judapies/Cabina-Extractora/2015/Cabina Extractora Simple/Cabina Extractora 120 - MAT/Plano Electrico/IMG_4619.JPG

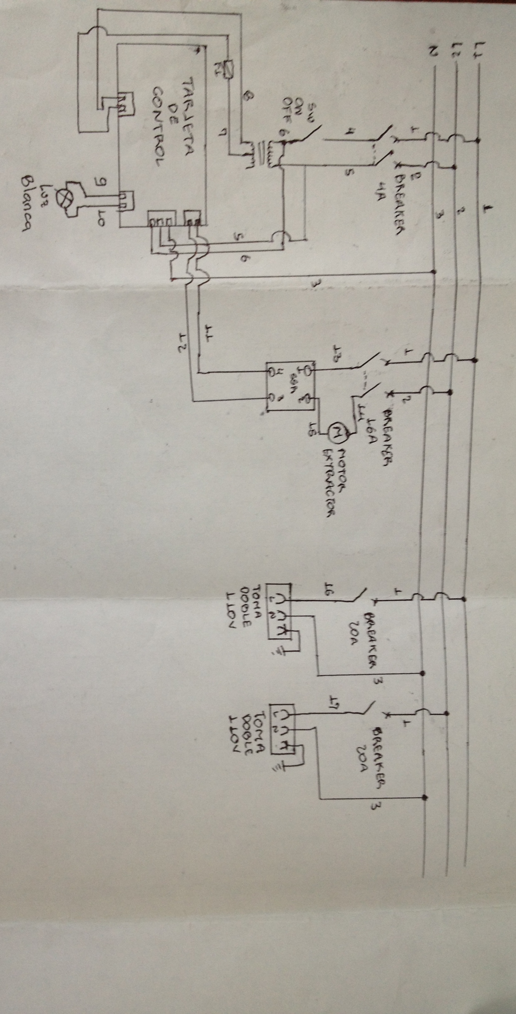
2015/Cabina Extractora Simple/Cabina Extractora 120 - MAT/Plano Electrico/IMG_4619.JPG
