judapies/Cabina-Extractora/2021/Cabina Extractora con Filtros HMI 120PP Avantika #0045886XX-XX OP2021140-141/Interfaz Nextion CEGH 3.5/Imagenes/SOFTWARE_AUTOCLAVE _HORIZONTAL_68L-01.png

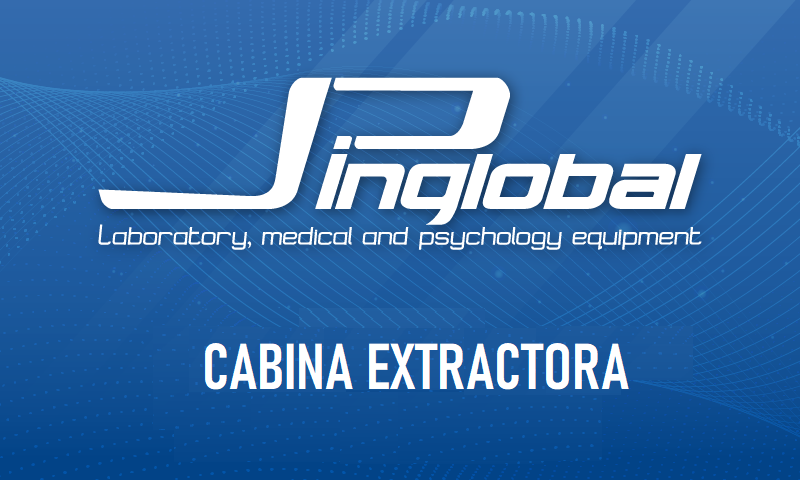
2021/Cabina Extractora con Filtros HMI 120PP Avantika #0045886XX-XX OP2021140-141/Interfaz Nextion CEGH 3.5/Imagenes/SOFTWARE_AUTOCLAVE _HORIZONTAL_68L-01.png
