judapies/Cabina-Extractora/2017/110/Cabina Extractora 110 Instruelectronic #004587680/Documentos/Motores_Amazonia.txt

Invermotor
Angie

Motor Trifasico 
1/2 HP Dixus 1200 RPM ->280000 IVA incluido con patas
1/2 HP WEG   1200 RPM ->401200 IVA incluido

Orbelec

Motor Trifasico 
Giovanny Diaz
1 HP WEG  1200 RPM ->468500 + IVA con patas

f y v

1/2 HP Siemens  1200 RPM ->354640 + IVA con patas

7452053
ext 111

Monica Bernal
PC Quimica
