judapies/Cabina-Extractora/2021/Cabina Extractora Sin Ductos 90TOPA GLCD CEMMIT #004588499 OP202114/Schematic/Gerber_Mufla/Mufla - CADCAM Mechanical 1.TXT

G04 PROTEUS RS274X GERBER FILE*
%FSLAX24Y24*%
%MOIN*%
%ADD22C,0.0080*%
G54D22*
X+0Y+0D02*
X+39133Y+0D01*
X+39133Y+30905D01*
X+0Y+30905D01*
X+0Y+0D01*
M00*
