judapies/Cabina-Extractora/2016/Cabina Sin Ductos Avantika #004587580/Plano Electrico CEH Sin Ductos/Pines Conectores Metalicos.txt

---------Luz Blanca--------------
#29->Pin 3
#28->Pin 1
---------------------------------
---------Luz UV------------------
#24->Pin 3
#22->Pin 1
---------------------------------
---------Motor ------------------
#19->Pin 3
#17->Pin 1
---------------------------------
---------Vidrio Abajo------------
#16->Pin 1
#20->Pin 2
#18->Pin 3
---------------------------------
---------Vidrio Arriba-----------
#21->Pin 1
#25->Pin 2
#23->Pin 3
---------------------------------
---------Sensor Flujo------------
Conector 5PINES
#10->Pin 1
#12->Pin 2
#13->Pin 3
#14->Pin 4
#15->Pin 5
---------------------------------
---------Motor Vidrio------------
#35->Pin 2
#34->Pin 1
---------------------------------

---------DAMPER------------------
Conector 5PINES
#27->Pin 1
#->Pin 2
#26->Pin 3
#8->Pin 4
#7->Pin 5
---------------------------------

********LONGITUD DE CABLES_______________________________________*
