judapies/Cabina-Extractora/2015/Cabina Extractora con Sensor Aire y Filtro-Damper/Intertek/Documentos/curvas-medidor-pelicula-caliente.jpg

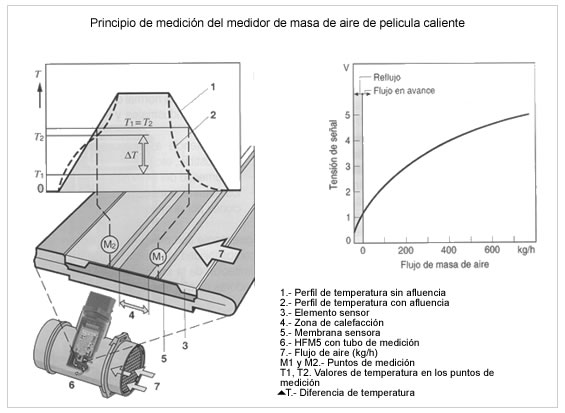
2015/Cabina Extractora con Sensor Aire y Filtro-Damper/Intertek/Documentos/curvas-medidor-pelicula-caliente.jpg
