judapies/Cabina-Extractora/2015/Cabina Extractora con Sensor Aire y Filtro-Damper/Intertek/Plano Electrico/Plano_Cabina_Extractora_Sensor_2.png

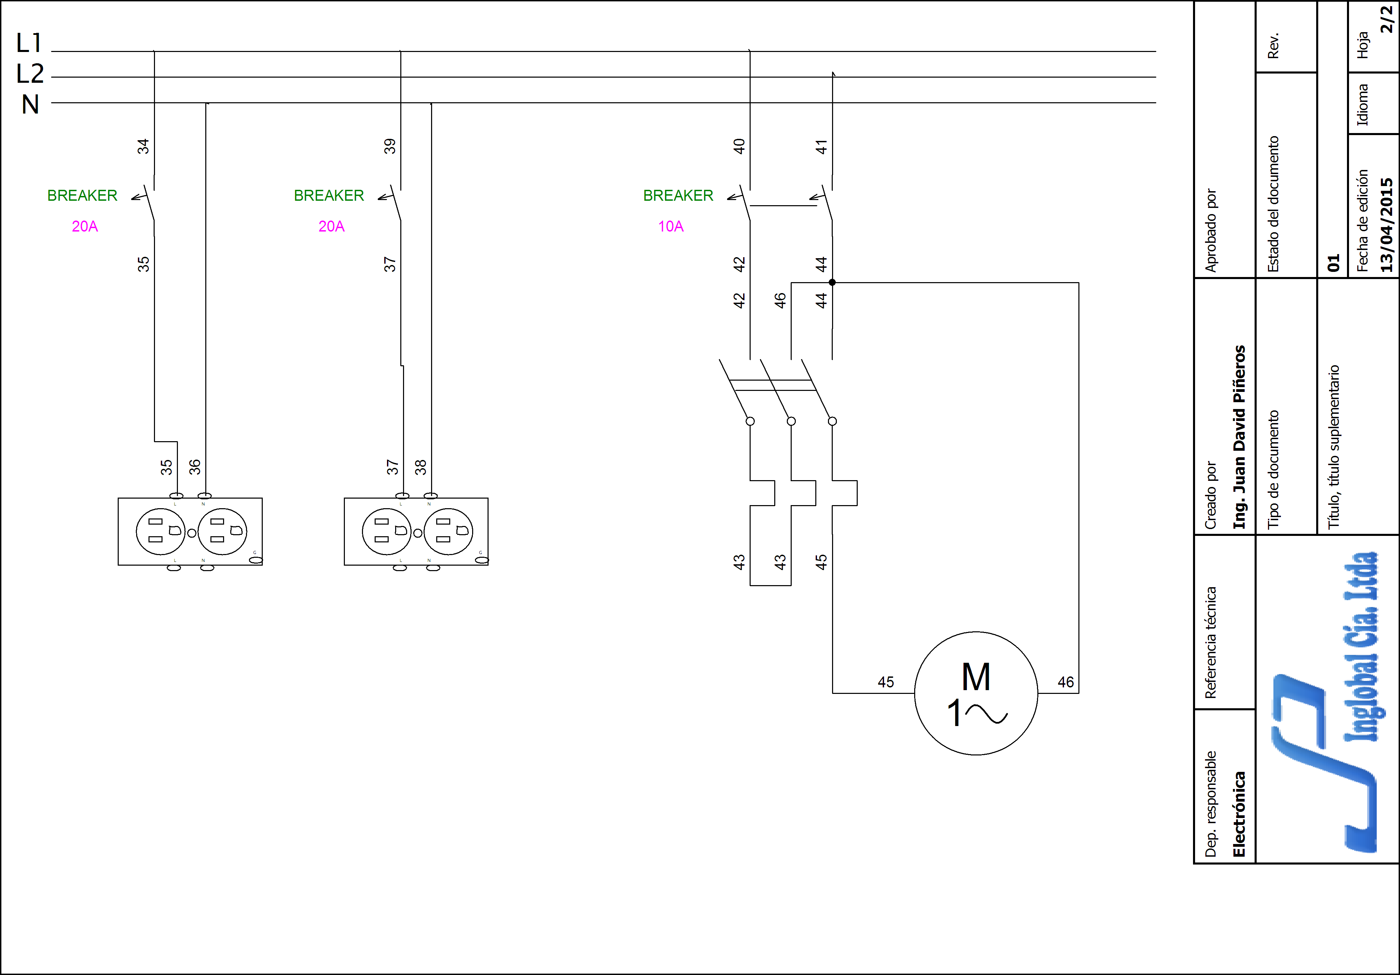
2015/Cabina Extractora con Sensor Aire y Filtro-Damper/Intertek/Plano Electrico/Plano_Cabina_Extractora_Sensor_2.png
