judapies/Cabina-Extractora/2015/Cabina Extractora con Sensor Aire y Filtro-Damper/Intertek/Plano Electrico/Plano_Electrico.JPG

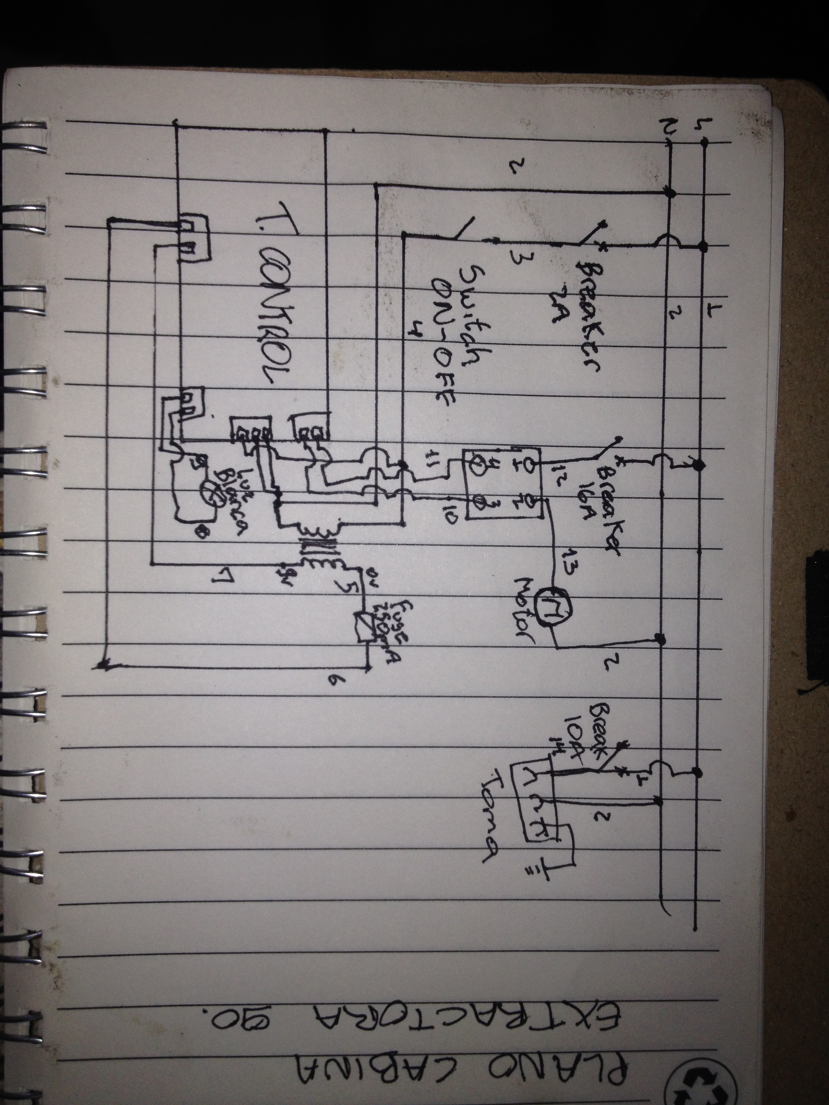
2015/Cabina Extractora con Sensor Aire y Filtro-Damper/Intertek/Plano Electrico/Plano_Electrico.JPG
