judapies/Cabina-Extractora/2015/Cabina Extractora con Sensor Aire-VariadorVelocidad/Paleosedes/Plano Electrico/Plano_Electrico_CabinaVariadorVelocidadSensor.JPG

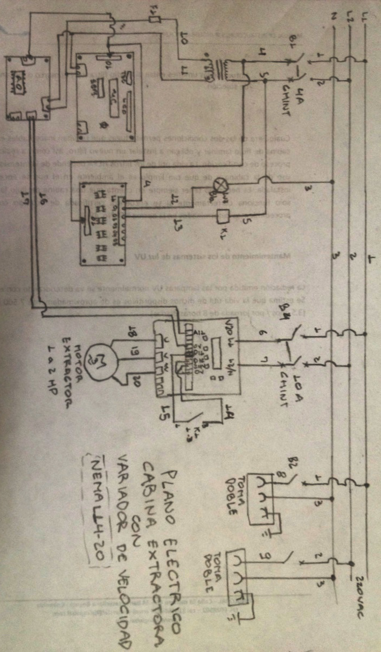
2015/Cabina Extractora con Sensor Aire-VariadorVelocidad/Paleosedes/Plano Electrico/Plano_Electrico_CabinaVariadorVelocidadSensor.JPG
