judapies/Cabina-Extractora/2018/Cabina Extractora 110 Sin Ductos U. Antioquia #004587817/AM AIR.JPG

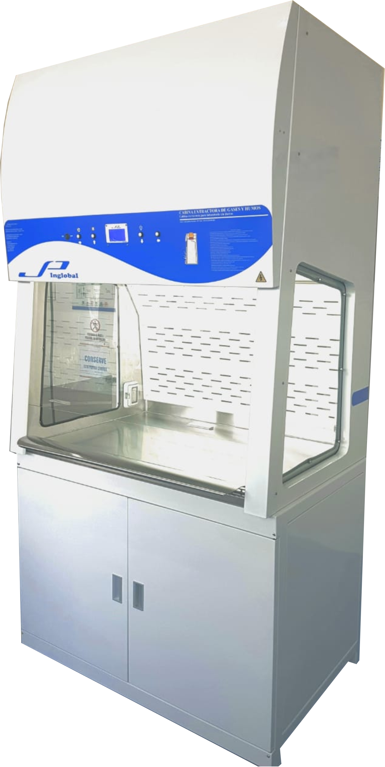
2018/Cabina Extractora 110 Sin Ductos U. Antioquia #004587817/AM AIR.JPG
