judapies/Cabina-Extractora/2020/Cabina Extractora Sin Ductos HMI 90 Artilab #004588087 OP2019193/Interfaz Nextion 3.5/Imagenes/CabinaB2.png

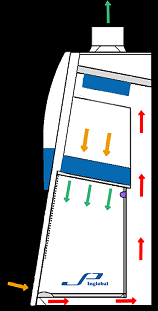
2020/Cabina Extractora Sin Ductos HMI 90 Artilab #004588087 OP2019193/Interfaz Nextion 3.5/Imagenes/CabinaB2.png
