judapies/Cabina-Extractora/2020/Cabina Extractora Sin Ductos HMI 90 Artilab #004588087 OP2019193/Interfaz Nextion/Imagenes/Diagrama_Cabina_Extractora.png

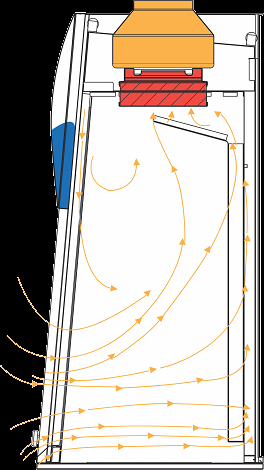
2020/Cabina Extractora Sin Ductos HMI 90 Artilab #004588087 OP2019193/Interfaz Nextion/Imagenes/Diagrama_Cabina_Extractora.png
