judapies/Cabina-Extractora/2018/Cabina Extractora 110 Avantika #004587792/Materiales/Bill Of Materials For Cabina_Extractora_Sensor.HTM

Bill Of Materials For Cabina_Extractora_Sensor.DSN
Design Title | : | Cabina_Extractora_Sensor.DSN
Author | : | <NONE>
Revision | : | <NONE>
Design Created | : | lunes, 14 de abril de 2014
Design Last Modified | : | miércoles, 24 de febrero de 2016
Total Parts In Design | : | 78
29 Resistors
 | Quantity: |  | References | Value | Order Code
 | 11 |  | R1, R5, R12-R15, R20, R30, R40, R41, R60 | 10k | M10K
 | 1 |  | R4 | 2K | M10K
 | 7 |  | R6, R22-R26, R50 | 1k | M10K
 | 5 |  | R7, R9, R11, R17, R19 | 1K | M330R
 | 5 |  | R8, R10, R16, R18, R21 | 330R | M330R
19 Capacitors
 | Quantity: |  | References | Value | Order Code
 | 4 |  | C1, C20, C30, C31 | 100nF
 | 2 |  | C2, C3 | 22pF
 | 5 |  | C7-C10, C13 | 0.1uF
 | 1 |  | C11 | 470uF
 | 1 |  | C12 | 10uF
 | 5 |  | C14-C18 | 0.1u | Maplin SC86T
 | 1 |  | C32 | 1uF
13 Integrated Circuits
 | Quantity: |  | References | Value | Order Code
 | 1 |  | U1 | LM324
 | 1 |  | U3 | PIC18F4550
 | 5 |  | U4, U6, U8, U10, U13 | MOC3021
 | 5 |  | U5, U7, U9, U11, U14 | BTA16
 | 1 |  | U12 | 7805
1 Transistors
 | Quantity: |  | References | Value | Order Code
 | 1 |  | Q1 | TIP41
1 Diodes
 | Quantity: |  | References | Value | Order Code
 | 1 |  | D2 | 1N4001
15 Miscellaneous
 | Quantity: |  | References | Value | Order Code
 | 1 |  | BR1 | BRIDGE
 | 1 |  | J3 | TBLOCK-I5
 | 7 |  | J4-J6, J9-J11, J13 | TBLOCK-I3
 | 1 |  | J7 | SIL-100-08
 | 1 |  | J8 | 9VAC
 | 1 |  | J12 | CONN-D15F
 | 1 |  | LCD1 | LM044L
 | 1 |  | RV1 | 1K | Digikey 3352T-102LF-ND
 | 1 |  | X1 | CRYSTAL
miércoles, 24 de febrero de 2016 2:39:54 p. m.
