judapies/Cabina-Extractora/2018/Cabina Extractora 120 Seleccion Scrubber #004587790/FJP- 35  REQUISICION DE MATERIALES ELECTRICOS.xlsx

Sheet: Formato requisiones
JP BIOINGENIERIA S.A.S |  |  | REQUISICION DE MATERIALES |  |  |  |  |  |  |  | FJP - 35
 |  |  |  |  |  |  |  |  |  |  | Version 01
Efectivo a partir de: 20 Dic 2017 |  |  |  |  |  | Documento de origen: DJP- 24 |  |  |  |  | Pág. 1 de 1
FECHA | 17 | 5 | 2018
PRODUCTO: | Cabina Extractora Selección de Scrubber |  |  |  |  |  |  | Orden de Pedido No. |  |  | N/A
 |  |  |  |  |  |  |  | Visita Técnica:
DESCRIPCION |  |  |  |  |  | Referencia |  |  | CANTIDAD REQUERIDA
Caja de Paso Plastica |  |  |  |  |  | 26X26 |  |  | 1
Breaker CHINT un polo | Triac | Triac | Triac | Triac | Triac | 4A | 1K | 1K | 1 | 10 | 10 | 10
Breaker CHINT un polo | Triac | Triac | Triac | Triac | Triac | 10A | 1K | 1K | 1 | 10 | 10 | 10
Conector Metalico | Resistencias 1/4W | Resistencias 1/4W | Resistencias 1/4W | Resistencias 1/4W | Resistencias 1/4W | 8 Pines |  |  | 1 | 28 | 28 | 28
Conector Metalico | Resistencias 1/4W | Resistencias 1/4W | Resistencias 1/4W | Resistencias 1/4W | Resistencias 1/4W | 2 Pines |  |  | 2 | 28 | 28 | 28
Conector Metalico | Resistencias 1/4W | Resistencias 1/4W | Resistencias 1/4W | Resistencias 1/4W | Resistencias 1/4W | 8 Pines |  |  | 1 | 28 | 28 | 28
Toma con cubierta |  |  |  |  |  | Hidrobox |  |  | 1
Frenos |  |  |  |  |  | para Riel Omega |  |  | 2
Riel Omega |  |  |  |  |  |  |  |  | 10cm
Prensacable |  |  |  |  |  | PG11 |  |  | 4
Clavija Leviton |  |  |  |  |  | NEMA 5-15P |  |  | 1
Boton |  |  |  |  |  | Reset |  |  | 1
Boton |  |  |  |  |  | Tipo Huevo Blanco |  |  | 4
Display LCD |  |  |  |  |  | 4X20 Azul |  |  | 1
Cable Encauchetado Centelsa |  |  |  |  |  | 3X12 |  |  | 5m
Cable Encauchetado Centelsa |  |  |  |  |  | 2X18 |  |  | 3,5m
Cable Blindado |  |  |  |  |  | 8X22 |  |  | 1,2m
Cable Vehicular Centelsa |  |  |  |  |  | AWG 18 Negro |  |  | 2m
Cable Vehicular Centelsa |  |  |  |  |  | AWG 18 Blanco |  |  | 2m
Cable Vehicular Centelsa |  |  |  |  |  | AWG 18 Rojo |  |  | 1m
Cable Vehicular Centelsa |  |  |  |  |  | AWG 12 Negro |  |  | 0,3m
Terminal Tipo Bala Macho |  |  |  |  |  | Roja o Azul |  |  | 15
Terminal Tipo Bala Hembra |  |  |  |  |  | Roja o Azul |  |  | 15
Regleta Polietileno |  |  |  |  |  | 15A |  |  | 2 Pines
Regleta Polietileno |  |  |  |  |  | 10A |  |  | 2 Pines
Fuente Meanwell |  |  |  |  |  | RS-15-12 |  |  | 1
SOLICITADO POR: |  |  |  | ENTREGADO POR: |  |  |  | RECIBIDO POR:

Sheet: Informe de compatibilidad
Informe de compatibilidad para FJP- 35 REQUISICION DE MATERIALES.XLS
Ejecutar el 10/05/2018 8:41
Las siguientes características de este libro no son compatibles con versiones anteriores de Excel. Estas características podrían perderse o degradarse si abre el libro con una versión anterior de Excel o si guarda el libro con un formato de archivo anterior.
Pérdida menor de fidelidad | Nº de apariciones | Versión
Algunas celdas o estilos de este libro contienen un formato no admitido en el formato de archivo seleccionado. Estos formatos se convertirán al formato más cercano disponible. | 1 | Excel 97-2003
