judapies/Cabina-Extractora/2018/Cabina Extractora 120 Seleccion Scrubber #004587790/FJP- 35  REQUISICION DE MATERIALES ELECTRONICOS.xlsx

Sheet: Formato requisiones
JP BIOINGENIERIA S.A.S |  |  | REQUISICION DE MATERIALES |  |  |  |  |  |  |  | FJP - 35
 |  |  |  |  |  |  |  |  |  |  | Version 01
Efectivo a partir de: 20 Dic 2017 |  |  |  |  |  | Documento de origen: DJP- 24 |  |  |  |  | Pág. 1 de 1
FECHA | 17 | 5 | 2018
PRODUCTO: | Cabina Extractora Selección de Scrubber |  |  |  |  |  |  | Orden de Pedido No. |  |  | N/A
 |  |  |  |  |  |  |  | Visita Técnica:
DESCRIPCION |  |  |  |  |  | Referencia |  |  | CANTIDAD REQUERIDA
OptoTriac |  |  |  |  |  | MOC3041 |  |  | 3
Triac | Triac | Triac | Triac | Triac | Triac | BT-137 | 1K | 1K | 3 | 10 | 10 | 10
Borneras | Borneras | Borneras | Borneras | Borneras | Borneras | 2 pines Verde | 10K (pequeño) | 10K (pequeño) | 5 | 2 | 2 | 2
Resistencias 1/4W | Resistencias 1/4W | Resistencias 1/4W | Resistencias 1/4W | Resistencias 1/4W | Resistencias 1/4W | 1k |  |  | 5 | 28 | 28 | 28
Resistencias 1/4W | Resistencias 1/4W | Resistencias 1/4W | Resistencias 1/4W | Resistencias 1/4W | Resistencias 1/4W | 10k |  |  | 10
Resistencias 1/4W | Resistencias 1/4W | Resistencias 1/4W | Resistencias 1/4W | Resistencias 1/4W | Resistencias 1/4W | 330R |  |  | 4
Diodo |  |  |  |  |  | 1N4004 |  |  | 1
Condensador Monolitico (Amarillo) |  |  |  |  |  | 104 |  |  | 2
Condensador Ceramico |  |  |  |  |  | 22pF |  |  | 2
Conector GP con uñas |  |  |  |  |  | 2 Pines |  |  | 1
Conector GP con uñas |  |  |  |  |  | 16 Pines |  |  | 2
Conector GP con uñas |  |  |  |  |  | 8 Pines |  |  | 1
Regleta profesional |  |  |  |  |  | 40 Pines |  |  | 1
Cristal de quarzo |  |  |  |  |  | 4MHz |  |  | 1
Poste Plastico |  |  |  |  |  |  |  |  | 4
Puente rectificador Redondo |  |  |  |  |  | 1,5A |  |  | 1
Transistor |  |  |  |  |  | TIP41C |  |  | 1
Regulador de Voltaje |  |  |  |  |  | LM7805 |  |  | 1
Disipador Metalico |  |  |  |  |  | Mediano |  |  | 1
Resotato |  |  |  |  |  | 10K |  |  | 1
Condensador Electrolitico |  |  |  |  |  | 10uF |  |  | 2
Condensador Electrolitico |  |  |  |  |  | 470uF |  |  | 1
Led |  |  |  |  |  | 5mm Rojo |  |  | 1
SOLICITADO POR: |  |  |  | ENTREGADO POR: |  |  |  | RECIBIDO POR:

Sheet: Informe de compatibilidad
Informe de compatibilidad para FJP- 35 REQUISICION DE MATERIALES.XLS
Ejecutar el 10/05/2018 8:41
Las siguientes características de este libro no son compatibles con versiones anteriores de Excel. Estas características podrían perderse o degradarse si abre el libro con una versión anterior de Excel o si guarda el libro con un formato de archivo anterior.
Pérdida menor de fidelidad | Nº de apariciones | Versión
Algunas celdas o estilos de este libro contienen un formato no admitido en el formato de archivo seleccionado. Estos formatos se convertirán al formato más cercano disponible. | 1 | Excel 97-2003
