judapies/Cabina-Extractora/2014/Cabina Extractora 180/Materiales/Listado de Componentes Abril.xlsx

 | Cabina Flujo Vertical 220V
 | Descripción | Referencia | Cantidad
 | OptoTriac | MOC3021 | 6
 | Triac | BT137 | 2
 |  | BTA-16 | 4
 | Borneras | 2 Pines Verdes | 7
 |  | 3 Pines Verde | 1
 | Conectores GP (con uñas) | 5 Pines | 1
 |  | 16 Pines | 2
 | Puente Rectificador | Redondo 1A | 1
 | Regulador de Voltaje | LM7805 | 1
 | Reostato | 10K | 1
 | Cristal de Cuarzo | 4MHz | 1
 | Resistencias 1/4W | 10K | 6
 |  | 1K | 6
 |  | 330R | 6
 | Condensador | 470uF/25V | 1
 |  | 10uF/16V | 3
 |  | 100nF (104) | 2
 |  | 22pF | 2
 | Display | 4X20 | 1
 | Microcontrolador | PIC 18F4550 | 1
 | Terminales | Según muestra | 8
 | Breaker CHINT 2 polos | 2A | 1
 | Breaker CHINT 1 polo | 10A | 1
 | Interruptor de balancin redondo | 20mm | 1
 | Toma doble blanca | Leviton | 1
 | Tapa de seguridad para toma doble | Plastica gris | 1
 | Regleta de polietileno | 15A | 1
 | Prensacable | PG11 | 4
 | Cable Encauchetado Conalcables | 4X12 | 3m
Ingenieros | Faiver H. Trujillo G | Juan David Piñeros E | 2014- Abr-15
