judapies/Cabina-Extractora/2015/Cabina Extractora con Sensor Aire-Damper/Materiales/Listado de Componentes Cabina Extractora.xlsx

Sheet: Parte Electronica 110V
 | Cabina Extractora 110V
 | Descripción | Referencia | Cantidad | Precio | Precio Total | Sitio de Compra | Dirección
 | OptoTriac | MOC3031 | 4 | $2088 | $8352 | Sigma Electronica Ltda | Av. Cra 24 No 61D-65
 | Triac | BTA-16 | 4 | $2030 | $8120 | Sigma Electronica Ltda | Av. Cra 24 No 61D-65
 | Borneras | 2 Pines Verdes | 2 | $350 | $700 | Electronica Digitel Ltda | Cra 9 # 19-30 LOC:216/217
 |  | 3 Pines Verde | 2 | $400 | $800 | Electronica Digitel Ltda | Cra 9 # 19-30 LOC:216/217
 | Conectores GP (con uñas) | 5 Pines | 1 | $400 | $400 | Electronica Digitel Ltda | Cra 9 # 19-30 LOC:216/217
 |  | 6 Pines | 1 | $400 | $400 | Electronica Digitel Ltda | Cra 9 # 19-30 LOC:216/217
 |  | 10 Pines | 2 | $700 | $1400 | Electronica Digitel Ltda | Cra 9 # 19-30 LOC:216/217
 |  | 16 Pines | 2 | $800 | $1600 | Electronica Digitel Ltda | Cra 9 # 19-30 LOC:216/217
 | Fusible Corto | 500 mA maximo | 1 | $100 | $100 | Electronica Digitel Ltda | Cra 9 # 19-30 LOC:216/217
 | Portafusible Aereo | Para fusible corto | 1 | $600 | $600 | Electronica Digitel Ltda | Cra 9 # 19-30 LOC:216/217
 | Disipador | Mediano para 7805 | 1 | $2000 | $2000 | Electronica Digitel Ltda | Cra 9 # 19-30 LOC:216/217
 | Puente Rectificador | Redondo 1A | 1 | $400 | $400 | Electronica Digitel Ltda | Cra 9 # 19-30 LOC:216/217
 | Regulador de Voltaje | LM7805 | 2 | $550 | $1100 | Electronica Digitel Ltda | Cra 9 # 19-30 LOC:216/217
 | Reostato | 10K | 1 | $300 | $300 | Electronica Digitel Ltda | Cra 9 # 19-30 LOC:216/217
 | Cristal de Cuarzo | 4MHz | 1 | $450 | $450 | Electronica Digitel Ltda | Cra 9 # 19-30 LOC:216/217
 | Resistencias 1/4W | 10K | 7 | $10 | $70 | Electronica Digitel Ltda | Cra 9 # 19-30 LOC:216/217
 |  | 1K | 6 | $10 | $60 | Electronica Digitel Ltda | Cra 9 # 19-30 LOC:216/217
 |  | 330R | 6 | $10 | $60 | Electronica Digitel Ltda | Cra 9 # 19-30 LOC:216/217
 | Condensador | 470uF/25V | 1 | $250 | $250 | Electronica Digitel Ltda | Cra 9 # 19-30 LOC:216/217
 |  | 10uF/16V | 3 | $150 | $450 | Electronica Digitel Ltda | Cra 9 # 19-30 LOC:216/217
 |  | 0,1 uF monolitico | 5 | $100 | $500 | Electronica Digitel Ltda | Cra 9 # 19-30 LOC:216/217
 |  | 22pF | 2 | $100 | $200 | Electronica Digitel Ltda | Cra 9 # 19-30 LOC:216/217
 | Display | 4X20 | 1 | $25000 | $25000 | Electronica Digitel Ltda | Cra 9 # 19-30 LOC:216/217
 | Transformador | 110V a 0-6-9V 450mA | 1 | $6500 | $6500 | Electronica Digitel Ltda | Cra 9 # 19-30 LOC:216/217
 | Varistor | 20D241K | 2 | $2000 | $4000 | Electronica Digitel Ltda | Cra 9 # 19-30 LOC:216/217
 | Microcontrolador | PIC 18F4550 | 1 | $15000 | $15000 | Electronica Digitel Ltda | Cra 9 # 19-30 LOC:216/217
 | Regleta Profesional | 40 pines | 3 | $1200 | $3600 | Electronica Digitel Ltda | Cra 9 # 19-30 LOC:216/217
 | Poste plastico | Para sujecion de tarjeta | 8 | $150 | $1200 | Electronica Digitel Ltda | Cra 9 # 19-30 LOC:216/217
 | Tarjetas Electronicas | Control | 1 | $14500 | $14500 | Yahiko Electronica Ltda | Calle 20 # 8-89
 |  | Etapa Potencia AC | 1 | $7000 | $7000 | Yahiko Electronica Ltda | Calle 20 # 8-89
 | Botones | Tipo huevo blanco | 4 | $1800 | $7200 | ATM Store SAS | Cra 9 # 19-30 LOC: 117
 | Transistor | TIP 41 | 1 | $800 | $800 | Electronica Digitel Ltda | Cra 9 # 19-30 LOC:216/217
 |  |  |  |  | $113112 | TOTAL
Ingenieros | Faiver H. Trujillo G | Juan David Piñeros E | 2014- Abr-15

Sheet: Parte Electrica 110V
Cabina Extractora 110V
Descripción | Referencia | Cantidad | Precio Unitario | Precio Total
Breaker CHINT 1 polo | 2A | 1 | $10000 | $10000
 | 16A | 1 | $10000 | $10000
 | 20A | 1 | $10000 | $10000
Toma doble blanca | Leviton | 1 | $2800 | $2800
Tapa de seguridad para toma doble | Plastica gris | 1 | $8000 | $8000
Regleta de polietileno | 30A | 1 | $4500 | $4500
Prensacable | PG11 | 4 | $1000 | $4000
Cable Encauchetado Conalcables | 3X12 | 4 | $4500 | $18000
Clavija | 110V 15A Leviton | 1 | $6500 | $6500
Rele de estado solido | HF 4-32VDC---25A-240VAC. | 1 | $45000 | $45000
Disipador para riel |  | 1 | $14000 | $14000
 |  |  |  | $132800

Sheet: Parte Electronica 220V
 | Cabina Extractora 220V
 | Descripción | Referencia | Cantidad | Precio | Precio Total | Sitio de Compra | Dirección
 | OptoTriac | MOC3031 | 4 | $2088 | $8352 | Sigma Electronica Ltda | Av. Cra 24 No 61D-65
 | Triac | BTA-16 | 4 | $2030 | $8120 | Sigma Electronica Ltda | Av. Cra 24 No 61D-65
 | Borneras | 2 Pines Verdes | 6 | $350 | $2100 | Electronica Digitel Ltda | Cra 9 # 19-30 LOC:216/217
 |  | 3 Pines Verde | 2 | $400 | $800 | Electronica Digitel Ltda | Cra 9 # 19-30 LOC:216/217
 | Conectores GP (con uñas) | 2 Pines | 3 | $400 | $1200 | Electronica Digitel Ltda | Cra 9 # 19-30 LOC:216/217
 |  | 5 Pines | 1 | $400 | $400 | Electronica Digitel Ltda | Cra 9 # 19-30 LOC:216/217
 |  | 6 Pines | 1 | $400 | $400 | Electronica Digitel Ltda | Cra 9 # 19-30 LOC:216/217
 |  | 10 Pines | 2 | $700 | $1400 | Electronica Digitel Ltda | Cra 9 # 19-30 LOC:216/217
 |  | 16 Pines | 2 | $800 | $1600 | Electronica Digitel Ltda | Cra 9 # 19-30 LOC:216/217
 | Fusible Corto | 500 mA maximo | 1 | $100 | $100 | Electronica Digitel Ltda | Cra 9 # 19-30 LOC:216/217
 | Portafusible Aereo | Para fusible corto | 1 | $600 | $600 | Electronica Digitel Ltda | Cra 9 # 19-30 LOC:216/217
 | Disipador | Mediano para 7805 | 1 | $2000 | $2000 | Electronica Digitel Ltda | Cra 9 # 19-30 LOC:216/217
 | Puente Rectificador | Redondo 1A | 2 | $400 | $800 | Electronica Digitel Ltda | Cra 9 # 19-30 LOC:216/217
 | Regulador de Voltaje | LM7805 | 2 | $550 | $1100 | Electronica Digitel Ltda | Cra 9 # 19-30 LOC:216/217
 | Reostato | 10K | 1 | $300 | $300 | Electronica Digitel Ltda | Cra 9 # 19-30 LOC:216/217
 | Cristal de Cuarzo | 4MHz | 1 | $450 | $450 | Electronica Digitel Ltda | Cra 9 # 19-30 LOC:216/217
 | Resistencias 1/4W | 10K | 15 | $10 | $150 | Electronica Digitel Ltda | Cra 9 # 19-30 LOC:216/217
 |  | 1K | 6 | $10 | $60 | Electronica Digitel Ltda | Cra 9 # 19-30 LOC:216/217
 |  | 330R | 6 | $10 | $60 | Electronica Digitel Ltda | Cra 9 # 19-30 LOC:216/217
 | Condensador | 470uF/25V | 2 | $250 | $500 | Electronica Digitel Ltda | Cra 9 # 19-30 LOC:216/217
 |  | 10uF/16V | 5 | $150 | $750 | Electronica Digitel Ltda | Cra 9 # 19-30 LOC:216/217
 |  | 0,1 uF monolitico | 10 | $100 | $1000 | Electronica Digitel Ltda | Cra 9 # 19-30 LOC:216/217
 |  | 22pF | 2 | $100 | $200 | Electronica Digitel Ltda | Cra 9 # 19-30 LOC:216/217
 | Display | 4X20 | 1 | $25000 | $25000 | Electronica Digitel Ltda | Cra 9 # 19-30 LOC:216/217
 | Transformador | 220V a 0-6-9V 500mA | 1 | $20000 | $20000 | Bobinados Especiales | Calle 21 # 8-81 OF:303
 | Varistor | 20D241K | 2 | $2000 | $4000 | Electronica Digitel Ltda | Cra 9 # 19-30 LOC:216/217
 | Microcontrolador | PIC 18F4550 | 1 | $15000 | $15000 | Electronica Digitel Ltda | Cra 9 # 19-30 LOC:216/217
 | Regleta Profesional | 40 pines | 4 | $1200 | $4800 | Electronica Digitel Ltda | Cra 9 # 19-30 LOC:216/217
 | Poste plastico | Para sujecion de tarjeta | 12 | $150 | $1800 | Electronica Digitel Ltda | Cra 9 # 19-30 LOC:216/217
 | Tarjetas Electronicas | Control | 1 | $14500 | $14500 | Yahiko Electronica Ltda | Calle 20 # 8-89
 |  | Acople Damper | 1 | $7000 | $7000 | Yahiko Electronica Ltda | Calle 20 # 8-89
 |  | Etapa Potencia AC | 1 | $7000 | $7000 | Yahiko Electronica Ltda | Calle 20 # 8-89
 | Botones | Tipo huevo blanco | 4 | $1800 | $7200 | ATM Store SAS | Cra 9 # 19-30 LOC: 117
 | Transistor | TIP 41 | 1 | $800 | $800 | Electronica Digitel Ltda | Cra 9 # 19-30 LOC:216/217
 | Sensor Flujo de Aire homologado | Bosch | 1 | $130000 | $130000 | Motorshop | Cra 26 # 63G-38
 | Conector Sensor Flujo de Aire | 5 Pines | 1 | $30000 | $30000 | Cauchos y pachas 7 de agosto | Calle 64 # 26-27
 |  |  |  |  | $299542 | TOTAL SIN DAMPER
 | Damper motorizado Motorizado actuador Honeywell | 24VAC | 1 | $345000 | $345000 | Proaire SAS | Calle 11 sur # 26-65
 | Transformador | 220VAC-24VAC 1A | 1 | $23200 | $23200 | Bobinados Especiales | Calle 21 # 8-81 OF:303
 |  |  |  |  | $667742 | TOTAL CON DAMPER
Ingenieros | Faiver H. Trujillo G | Juan David Piñeros E | 2014- Abr-15

Sheet: Parte Electrica 220V
Cabina Extractora 220V
Descripción | Referencia | Cantidad | Precio Unitario | Precio Total | Sitio de Compra | Dirección
Breaker CHINT 2 polo | 2A | 1 | $20000 | $20000 | Poliem Pack LTDA | Carrera 12 #17-15
 | 16A | 1 | $20000 | $20000 | Poliem Pack LTDA | Carrera 12 #17-15
Breaker CHINT 1 polo | 20A | 2 | $10000 | $20000 | Poliem Pack LTDA | Carrera 12 #17-15
Toma doble blanca | Leviton | 2 | $2800 | $5600 | Poliem Pack LTDA | Carrera 12 #17-15
Tapa de seguridad para toma doble | Plastica gris | 2 | $8000 | $16000 | Poliem Pack LTDA | Carrera 12 #17-15
Regleta de polietileno | 30A | 1 | $5500 | $5500 | Poliem Pack LTDA | Carrera 12 #17-15
Prensacable | PG11 | 4 | $800 | $3200 | Poliem Pack LTDA | Carrera 12 #17-15
Cable Encauchetado Centelsa | 4X12 | 5 | $5500 | $27500 | Poliem Pack LTDA | Carrera 12 #17-15
Clavija industrial de seguridad 1/4 de giro 20A NEMA | L14-20P | 1 | $28000 | $28000 | Poliem Pack LTDA | Carrera 12 #17-15
Toma industrial de seguridad 1/4 de giro 20A NEMA | L14-20R | 1 | $28000 | $28000 | Poliem Pack LTDA | Carrera 12 #17-15
Buzzer con lampara de señalización | 220VAC Rojo | 1 | $8000 | $8000 | Poliem Pack LTDA | Carrera 12 #17-15
Luz Blanca LED | 10W | 1 | $38000 | $38000 | Poliem Pack LTDA | Carrera 12 #17-15
Contactor CHINT | 12A | 1 | $20000 | $20000 | Poliem Pack LTDA | Carrera 12 #17-15
Relé Termico CHINT | 7-12A | 1 | $25000 | $25000 | Poliem Pack LTDA | Carrera 12 #17-15
 |  |  |  | $264800 | TOTAL SIN MOTOR
Ventilador Centrifugo tipo Blower : Motor 1.5HP VOGES 1700RPM | 220VAC | 1 | $1929500 | $1929500 | Nacional de Extractores y turbinas | Av. Calle 6 # 26-86
 |  |  |  | $2459100 | TOTAL CON MOTOR
