judapies/Cabina-Extractora/2016/Cabina Sin Ductos Avantika #004587580/Materiales/Listado de Componentes Cabina Extractora sin Ductos.xlsx

Sheet: Parte Electronica 110V
 | Cabina Bioseguridad 110V
 | Descripción | Referencia | Sitio de Compra | Dirección | Cantidad | Precio | Precio Total
 | OptoTriac | MOC3031 | Sigma Electronica Ltda | Av. Cra 24 No 61D-65 | 5 | $2552 | $12760
 | Triac | BTA-16 | Sigma Electronica Ltda | Av. Cra 24 No 61D-65 | 5 | $2320 | $11600
 | Borneras | 2 Pines Verdes | Sanyvi Electronics | Cra 9 # 19-30 LOC:212 | 3 | $350 | $1050
 |  | 3 Pines Verde | Sanyvi Electronics | Cra 9 # 19-30 LOC:212 | 10 | $400 | $4000
 | Conectores GP (con uñas) | 8 Pines | Sanyvi Electronics | Cra 9 # 19-30 LOC:212 | 1 | $400 | $400
 |  | 2 Pines | Sanyvi Electronics | Cra 9 # 19-30 LOC:212 | 3
 |  | 4 Pines | Sanyvi Electronics | Cra 9 # 19-30 LOC:212 | 2
 |  | 16 Pines | Sanyvi Electronics | Cra 9 # 19-30 LOC:212 | 2 | $800 | $1600
 | Fusible Corto | 500 mA maximo | Sanyvi Electronics | Cra 9 # 19-30 LOC:212 | 1 | $100 | $100
 | Portafusible Aereo | Para fusible corto | Sanyvi Electronics | Cra 9 # 19-30 LOC:212 | 1 | $600 | $600
 | Disipador | Mediano para 7805 | Sanyvi Electronics | Cra 9 # 19-30 LOC:212 | 1 | $2000 | $2000
 | Puente Rectificador | Redondo 1A | Sanyvi Electronics | Cra 9 # 19-30 LOC:212 | 1 | $400 | $400
 | Regulador de Voltaje | LM7805 | Sanyvi Electronics | Cra 9 # 19-30 LOC:212 | 1 | $550 | $550
 | Reostato pequeño | 10K | Sanyvi Electronics | Cra 9 # 19-30 LOC:212 | 1 | $300 | $300
 | Cristal de Cuarzo | 4MHz | Sanyvi Electronics | Cra 9 # 19-30 LOC:212 | 2 | $450 | $900
 | Resistencias 1/4W | 10K | Sanyvi Electronics | Cra 9 # 19-30 LOC:212 | 7 | $10 | $70
 |  | 1K | Sanyvi Electronics | Cra 9 # 19-30 LOC:212 | 14 | $10 | $140
 |  | 330R | Sanyvi Electronics | Cra 9 # 19-30 LOC:212 | 6 | $10 | $60
 | Condensador | 470uF/25V | Sanyvi Electronics | Cra 9 # 19-30 LOC:212 | 1 | $250 | $250
 |  | 10uF/16V | Sanyvi Electronics | Cra 9 # 19-30 LOC:212 | 2 | $150 | $300
 |  | 0.1uF Monolitico | Sanyvi Electronics | Cra 9 # 19-30 LOC:212 | 6 | $100 | $600
 |  | 22pF | Sanyvi Electronics | Cra 9 # 19-30 LOC:212 | 4 | $100 | $400
 |  | 0.1uF Tantalio superficial (CT1206 0.1UF35) | Sigma Electronica Ltda | Av. Cra 24 No 61D-65 | 10 | $406 | $4060
 | Display Grafico Azul | 128X64 | Sigma Electronica Ltda | Av. Cra 24 No 61D-65 | 1 | $70000 | $70000
 | Transformador | 110V a 0-6-9V 450mA | Sanyvi Electronics | Cra 9 # 19-30 LOC:212 | 1 | $6500 | $6500
 | Varistor | 20D241K | Sanyvi Electronics | Cra 9 # 19-30 LOC:212 | 2 | $2000 | $4000
 | Microcontrolador | PIC 18F4550 | Sanyvi Electronics | Cra 9 # 19-30 LOC:212 | 2 | $15000 | $30000
 | Regleta Profesional | 40 pines | Sanyvi Electronics | Cra 9 # 19-30 LOC:212 | 2 | $1200 | $2400
 | Poste plastico | Para sujecion de tarjeta | Sanyvi Electronics | Cra 9 # 19-30 LOC:212 | 4 | $150 | $600
 | Tarjetas Electronicas | Control | Yahiko Electronica Ltda | Calle 20 # 8-89 | 1 | $17000 | $17000
 | Botones | Tipo huevo blanco | ATM Store SAS | Cra 9 # 19-30 LOC: 117 | 4 | $1800 | $7200
 | Sensor de Presión Diferencial | MPXV5400DP | Sigma Electronica Ltda | Av. Cra 24 No 61D-65 | 2 | $46400 | $92800
 | Transistor | 2N3904 | Sanyvi Electronics | Cra 9 # 19-30 LOC:212 | 2 | $200 | $400
 | Diodo | 1N4004 | Sanyvi Electronics | Cra 9 # 19-30 LOC:212 | 2 | $200 | $400
 | Led | 5mm rojo | Sanyvi Electronics | Cra 9 # 19-30 LOC:212 | 1 | $500 | $500
 |  |  | TOTAL |  |  |  | $273940
Ingenieros | Faiver H. Trujillo G | Juan David Piñeros E | 2014- Abr-15

Sheet: Parte Electrica 110V
Cabina Bioseguridad
Descripción | Referencia | Cantidad
Breaker CHINT 1 polo | 4A | 2
 | 10A | 1
Interruptor de balancin redondo | 20mm Negro | 1
Regleta de polietileno | 30A | 1
 | 5A | 2
Prensacable | PG11 | 4
 | PG13.5 | 4
Cable Encauchetado Centelsa | 3X12 | 5m
Clavija | 110V 15A Leviton | 1
Frenos | Para riel | 2
Contactor | Bobina 110V; 9A | 1
 | Bobina 110V; 18A | 1
Buzzer | 110V | 1

Sheet: Hoja1
 | Cabina Flujo Vertical 220V
 | Descripción | Referencia | Cantidad
 | OptoTriac | MOC3021 | 6
 | Triac | BT137 | 2
 |  | BTA-16 | 4
 | Borneras | 2 Pines Verdes | 7
 |  | 3 Pines Verde | 1
 | Conectores GP (con uñas) | 5 Pines | 1
 |  | 16 Pines | 2
 | Puente Rectificador | Redondo 1A | 1
 | Regulador de Voltaje | LM7805 | 1
 | Reostato | 10K | 1
 | Cristal de Cuarzo | 4MHz | 1
 | Resistencias 1/4W | 10K | 6
 |  | 1K | 6
 |  | 330R | 6
 | Condensador | 470uF/25V | 1
 |  | 10uF/16V | 3
 |  | 100nF (104) | 2
 |  | 22pF | 2
 | Display | 4X20 | 1
 | Microcontrolador | PIC 18F4550 | 1
 | Terminales | Según muestra | 8
 | Breaker CHINT 2 polos | 2A | 1
 | Breaker CHINT 1 polo | 10A | 1
 | Interruptor de balancin redondo | 20mm | 1
 | Toma doble blanca | Leviton | 1
 | Tapa de seguridad para toma doble | Plastica gris | 1
 | Regleta de polietileno | 15A | 1
 | Prensacable | PG11 | 4
 | Cable Encauchetado Conalcables | 4X12 | 3m
Ingenieros | Faiver H. Trujillo G | Juan David Piñeros E | 2014- Abr-15
