judapies/Cabina-Extractora/2018/Cabina Extractora 110 Avantika #004587792/Documentos/Listado de Componentes-16-10-2015.xlsx

Cabina Extractora 110V
Descripción | Referencia | Cantidad Total
Breaker CHINT 1 polo | 4A | 10
 | 20A | 10
Toma doble blanca | Leviton | 20
Tapa de seguridad para toma doble | Plastica gris | 20
Regleta de polietileno | 30A | 10
Prensacable | PG11 | 20
 | PG13.5 | 20
Cable Encauchetado Centelsa | 3X12 | 50m
Buzzer con lampara de señalización | 220VAC Rojo | 10
Clavija 110V amarilla | Leviton | 11
Cable #12 Centelsa | Negro | 100m
Cable #20 Centelsa | Negro | 300m
Amarres plasticos Negros | 4 Pulgadas | (1 bolsa)100
Terminal Aislada Tipo U AWG 12-10 Amarillo | Ancho Interno U:4,3mm (5/32") | (1 bolsa)100
Riel Omega |  | 2m
Frenos para Riel |  | 20
Pulsador Plastico Parada Emergencia | Cabeza: 40mmФ; Troquel: 22mm Ф ; Contacto:NC | 1
Selector de muletilla plastico | Posiciones: 2(0-1); Troquel:22mm; Contacto:NA | 1
Cable para alta Temperatura | Siliconado Blanco | 3m
