judapies/Cabina-Extractora/2015/Cabina Extractora con Sensor Aire y Filtro-Damper/Universidad de la Amazonia/Schematic/Control_Damper.DXF

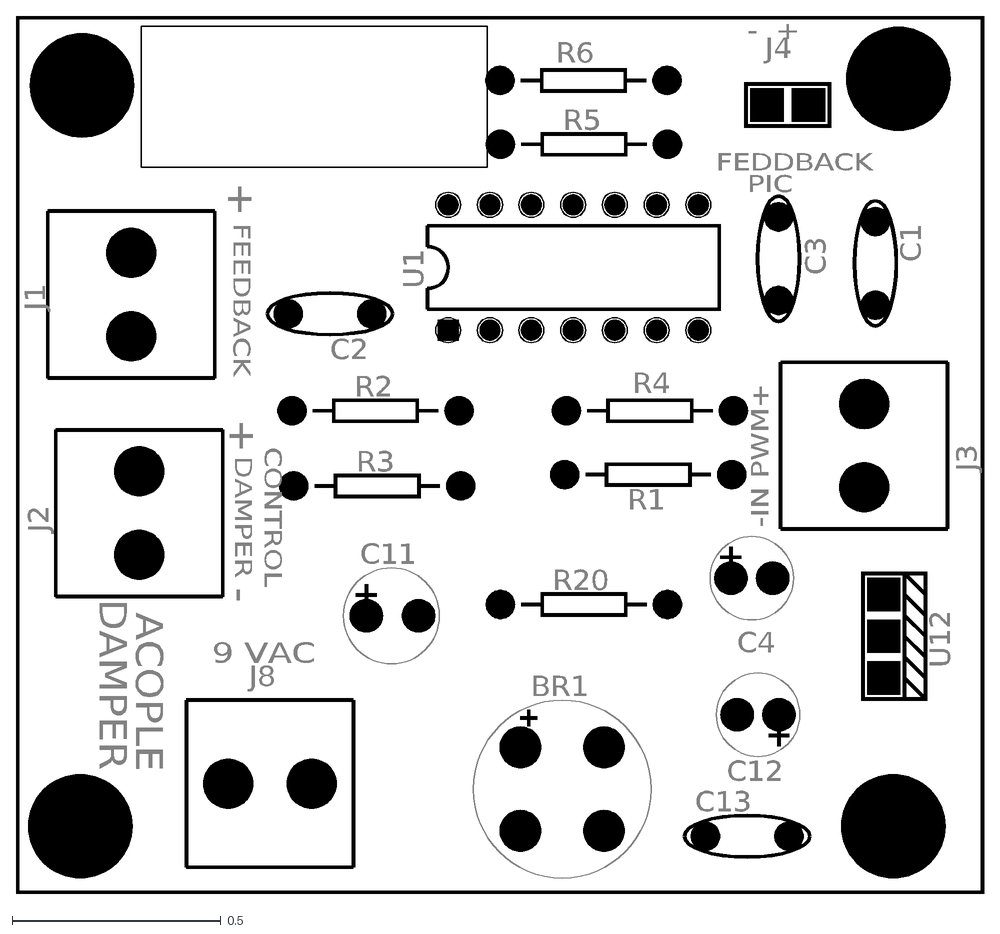
[picture p13: CAD file, 2021-07-15]
2015/Cabina Extractora con Sensor Aire y Filtro-Damper/Universidad de la Amazonia/Schematic/Control_Damper.DXF
BR1
C1
C2
R20
U12
C11
C12
C13
J8
U1
R4
J3
C4
R1
R2
R3
R5
R6
J1
J2
J4
C3
CONTROL
DAMPER
FEEDBACK
+
-
9 VAC
-IN PWM+
ACOPLE
FEDDBACK
PIC
- +
