judapies/Cabina-Extractora/2016/Cabina Sin Ductos Avantika #004587580/Schematic/CabinaEspecial.DXF

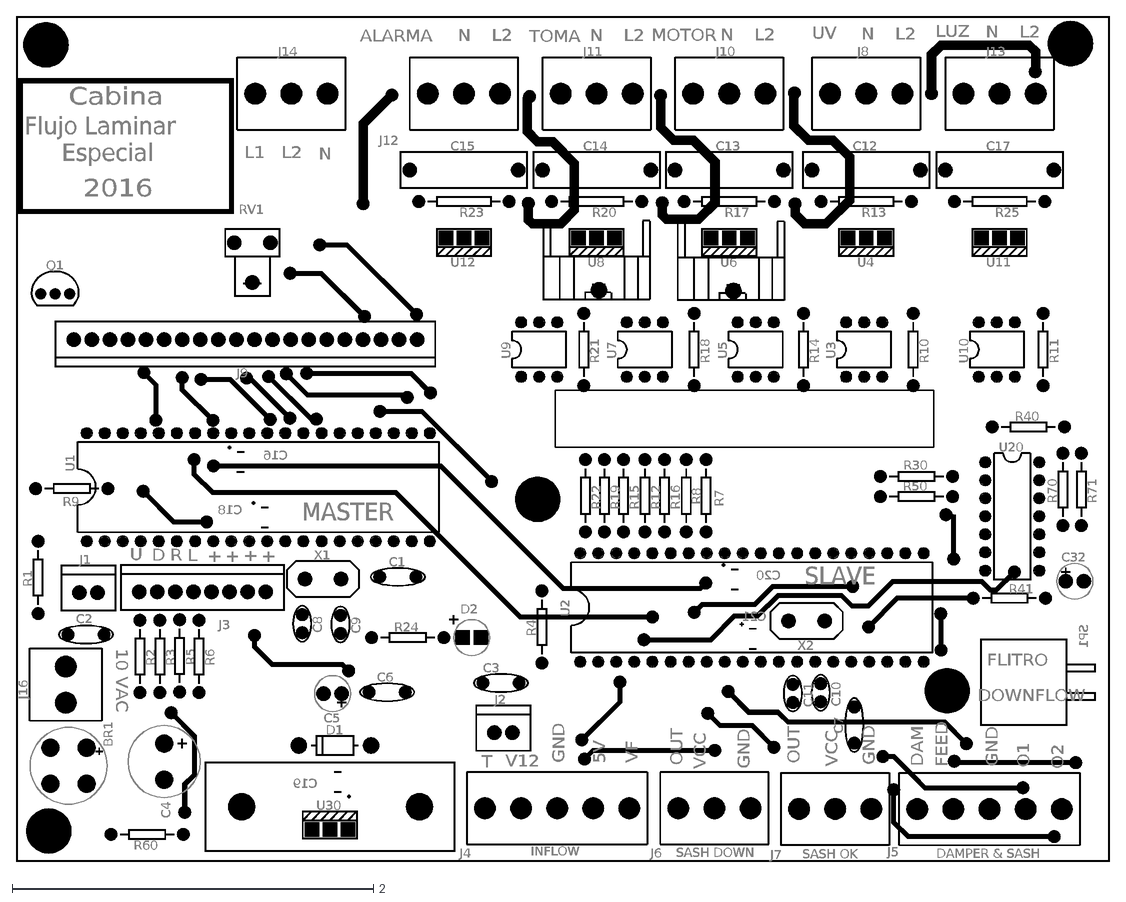
[picture p14: CAD file, 2021-07-15]
2016/Cabina Sin Ductos Avantika #004587580/Schematic/CabinaEspecial.DXF
BR1
U1
U2
J16
C4
R60
U30
D1
C5
C6
C1
R1
J1
C2
J3
R2
R3
R5
R6
J9
R9
X1
C8
C9
J4
J6
J7
SP1
R16
R12
R15
R19
R22
U10
U3
U5
U7
U9
R11
U11
C17
R25
J13
R4
C7
J2
Q1
R10
U4
C12
R13
J8
C13
R17
C14
R20
C15
R23
R14
R18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
