judapies/Cabina-Extractora/2016/Cabinas_Alfa&Omega/Cabina # 004587577/Schematic Final/AdaptadorLCD.DXF

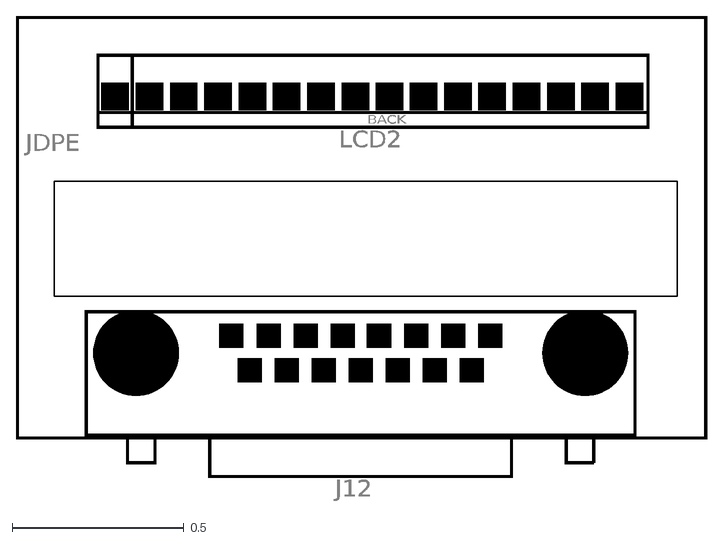
[picture p16: CAD file, 2021-07-15]
2016/Cabinas_Alfa&Omega/Cabina # 004587577/Schematic Final/AdaptadorLCD.DXF
BACK
LCD2
J12
JDPE
