judapies/Cabina-Extractora/2017/110/Cabina Extractora 110 Avantika #004587602/Schematic Final/lcd.dxf

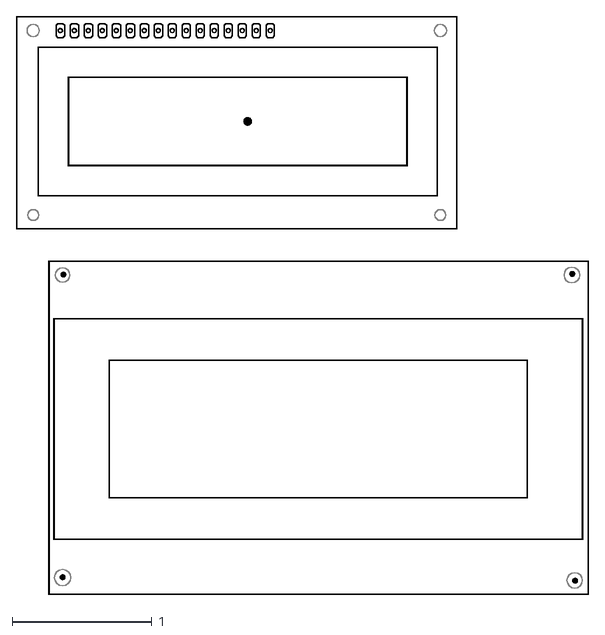
[picture p17: CAD file, 2021-07-15]
2017/110/Cabina Extractora 110 Avantika #004587602/Schematic Final/lcd.dxf
4.10 x 4.14
