judapies/Cabina-Extractora/2017/120/Cabina Extractora 120 Alfa&Omega #004587694/Schematic Final/Cabina_Extractora_Sensor.DXF

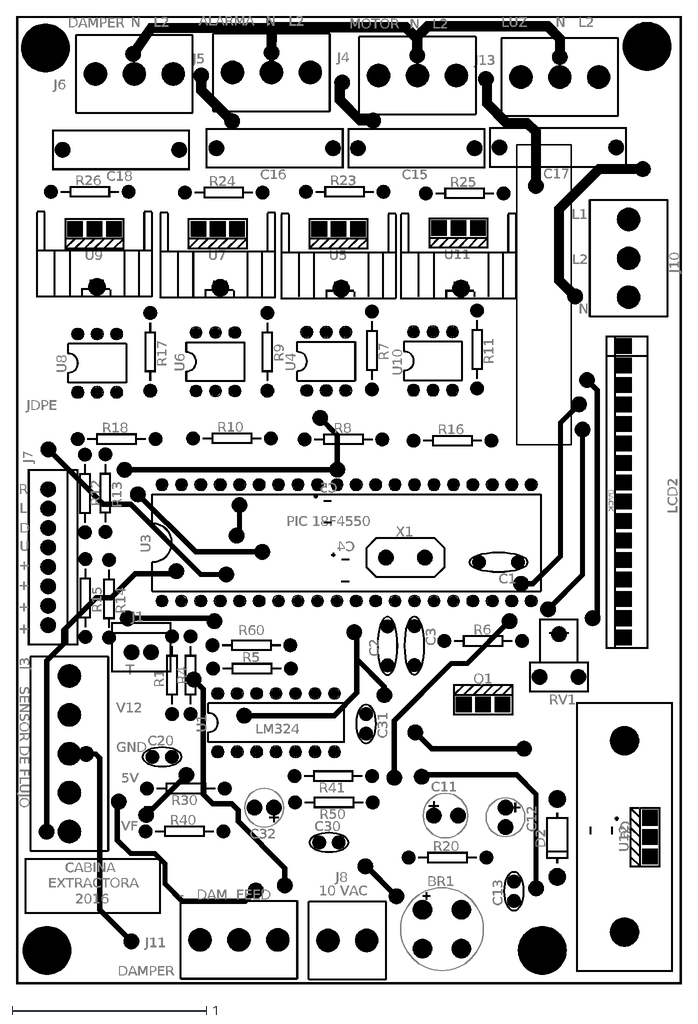
[picture p18: CAD file, 2021-07-15]
2017/120/Cabina Extractora 120 Alfa&Omega #004587694/Schematic Final/Cabina_Extractora_Sensor.DXF
BR1
J8
U12
D2
R20
C11
C12
C13
U3
J3
U1
U4
U5
U6
U7
U8
U9
U10
U11
R41
C32
R50
C30
R30
R40
C20
J11
R5
R60
R11
R16
R9
R10
R7
R8
R17
R18
C17
R25
J13
C15
C16
C18
R6
Q1
C31
J7
J5
J4
J6
J10
R1
R4
R12
R13
R14
R15
RV1
R24
R26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
