judapies/Cabina-Extractora/2017/120/Cabina Extractora 120 Control Remoto Avantika #004587683/Schematic Final/Cabina_Extractora_Infrarrojo.DXF

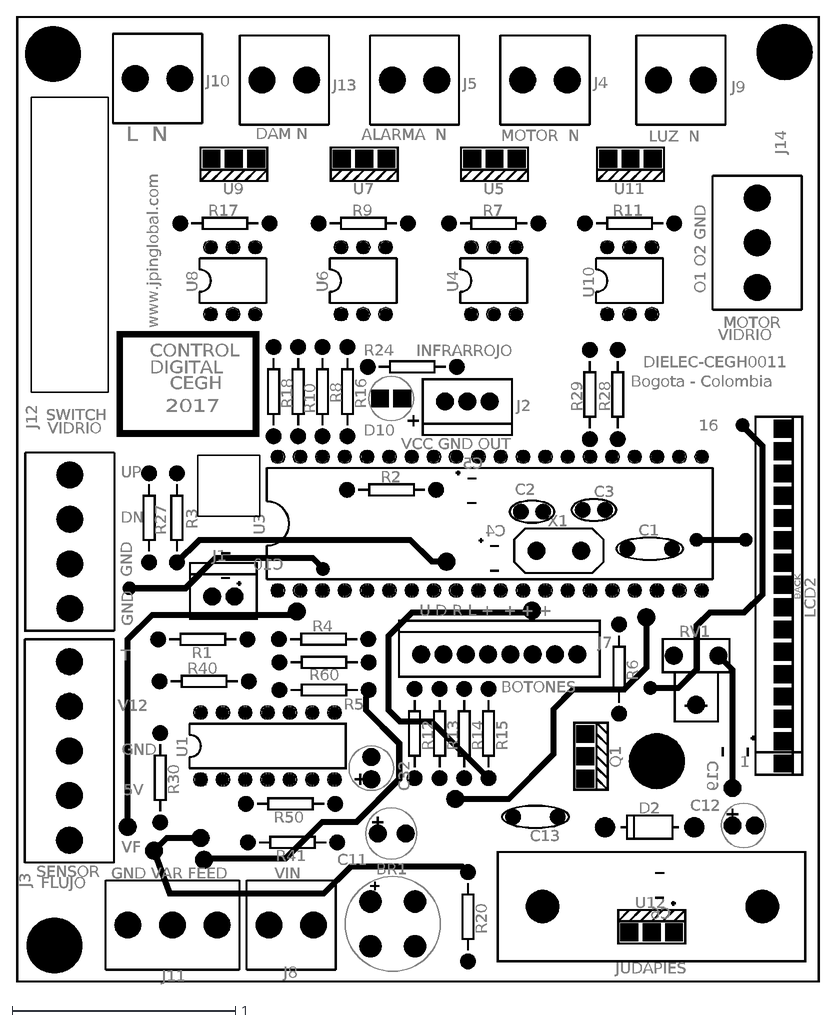
[picture p19: CAD file, 2021-07-15]
2017/120/Cabina Extractora 120 Control Remoto Avantika #004587683/Schematic Final/Cabina_Extractora_Infrarrojo.DXF
BR1
J8
C11
R20
U12
D2
C12
C13
U3
J3
J12
J7
BACK
LCD2
U1
R41
C32
R50
R30
R40
R5
R60
J11
R12
R13
R14
R15
X1
C2
C3
C1
R27
R3
R6
Q1
RV1
R16
U10
R8
R10
J2
R18
R11
U11
J9
U4
R7
U5
J4
U6
R9
U7
J5
U8
R17
U9
J13
J10
J14
R28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
