judapies/Cabina-Extractora/2018/Cabina Extractora 120 Sin Ductos Medidor Flujo #004587780/Schematic/CabinaBioseguridadV1.1.DXF

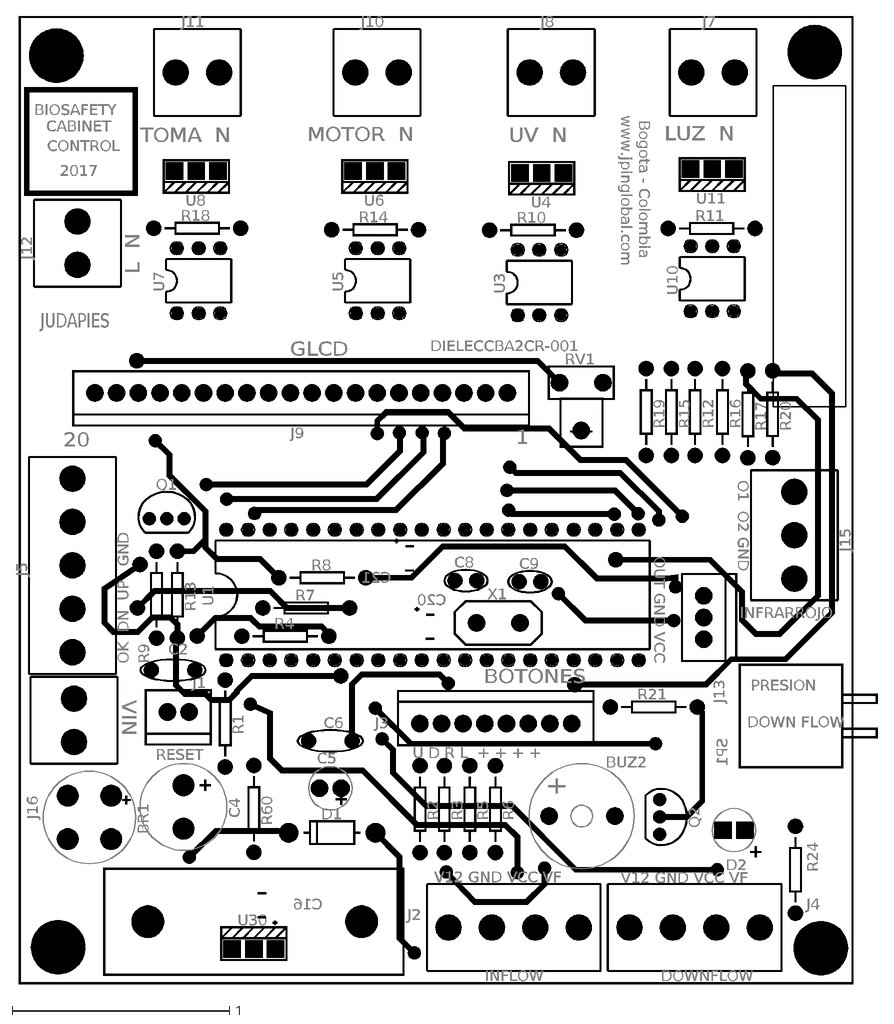
[picture p22: CAD file, 2021-07-15]
2018/Cabina Extractora 120 Sin Ductos Medidor Flujo #004587780/Schematic/CabinaBioseguridadV1.1.DXF
SP1
U1
J16
BR1
C4
R60
U30
D1
C5
C6
J2
J4
J3
R2
R3
R5
R6
R16
R12
R15
R19
U10
U11
R11
J7
U3
U4
J8
R10
U5
U6
R14
J10
U7
U8
J11
R18
J12
J9
R24
D2
J1
R1
C2
R4
R7
X1
C8
C9
R21
Q2
+
BUZ2
RV1
Q1
R9
C20
C21
C16
J13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
