judapies/Cabina-Extractora/2018/Cabina Extractora Biobase #004587860/Schematic/CabinaBioseguridadV1.DXF

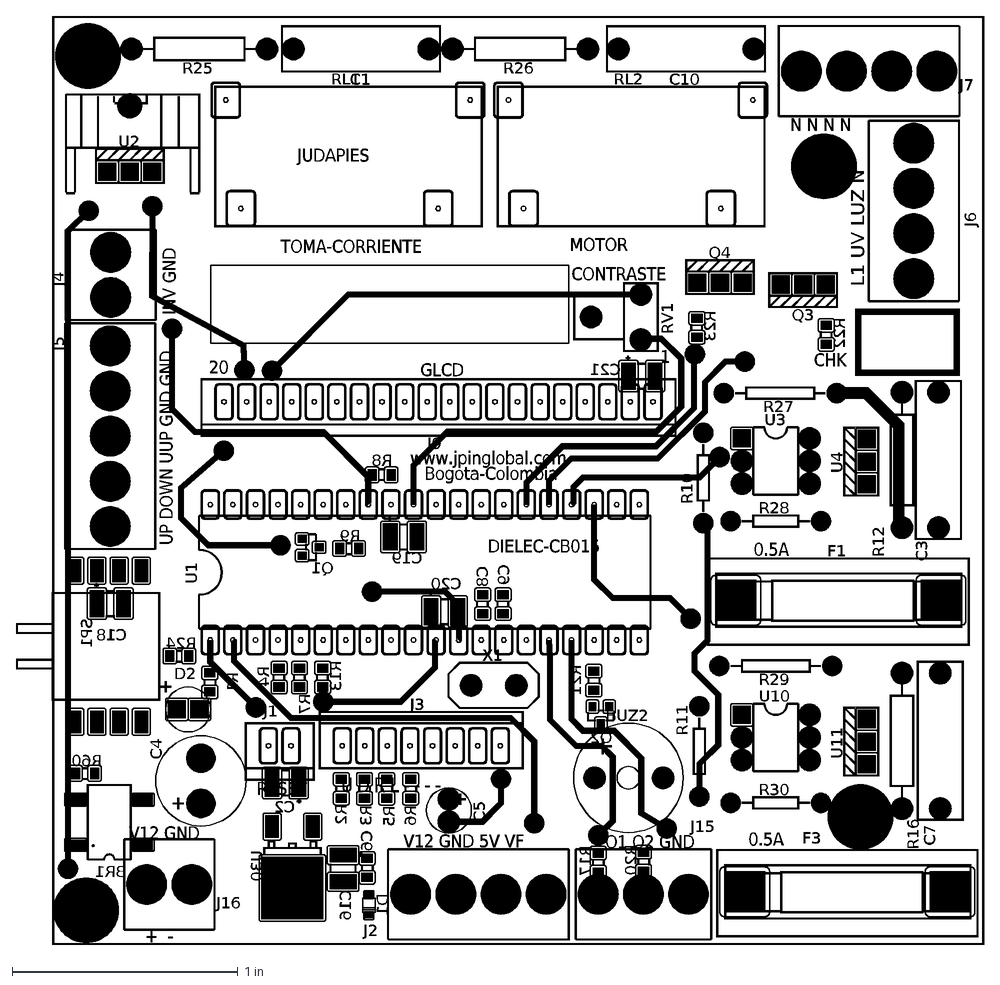
[picture p23: CAD file, 2021-07-15]
2018/Cabina Extractora Biobase #004587860/Schematic/CabinaBioseguridadV1.DXF
U1
R1
J1
C2
X1
C8
C9
J16
BR1
R60
C4
U30
D1
C5
C6
J2
SP1
J5
R4
R7
R13
J3
R2
R3
R5
R6
J9
J15
R17
R20
J6
J7
R21
Q2
+
BUZ2
R9
Q1
R11
U10
R29
R30
U11
C7
R16
F3
R10
U3
R27
R28
U4
R12
C3
F1
R22
Q3
RL2
R26
C10
R23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
