judapies/Cabina-Extractora/2019/Cabina Extractora 120 Artilab #004587962 OP.201986/Schematic/Cabina_Extractora.DXF

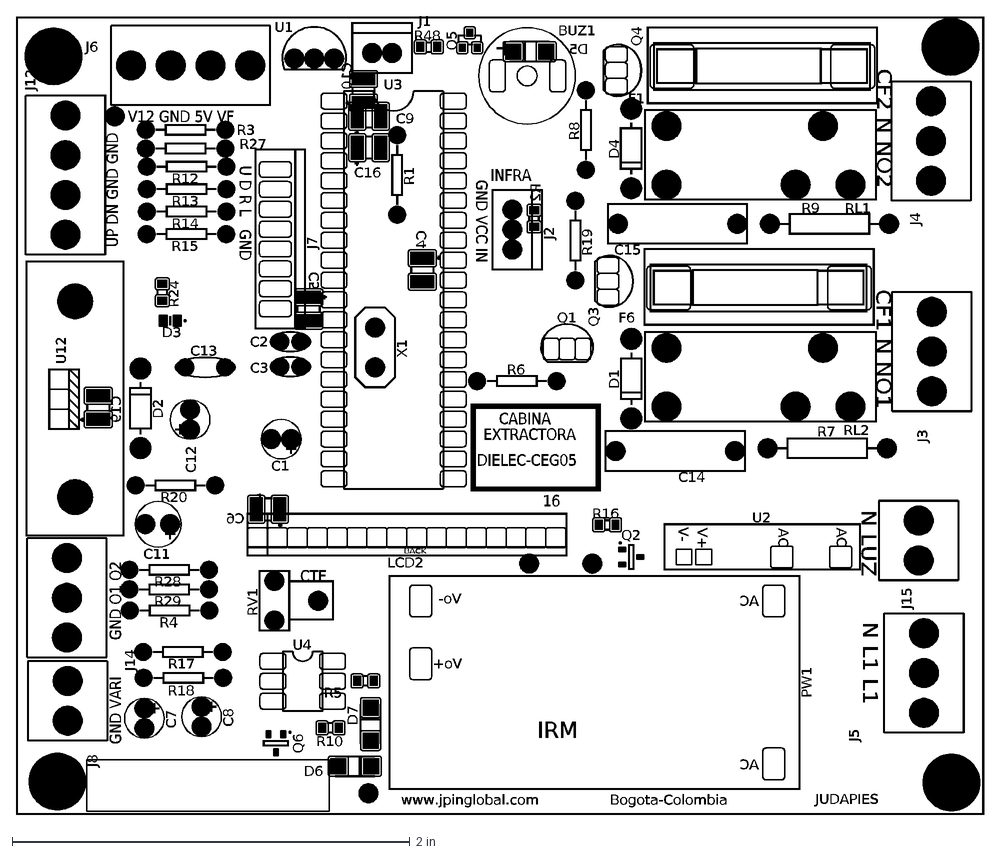
[picture p24: CAD file, 2021-07-15]
2019/Cabina Extractora 120 Artilab #004587962 OP.201986/Schematic/Cabina_Extractora.DXF
www.jpinglobal.com
U3
AC
Vo+
Vo-
PW1
C11
R20
U12
D2
C12
C13
J7
R12
R13
R14
R15
X1
C2
C3
J12
R27
R3
J6
R16
Q2
V+
V-
U2
BACK
LCD2
J5
J15
R19
Q3
D1
RL2
F6
R7
C14
U1
R8
Q4
D4
RL1
F1
R9
C15
R28
R29
J14
R48
D5
Q5
+
BUZ1
C1
R4
U4
D6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
