judapies/Cabina-Extractora/2019/Cabina Extractora 180 SGS #004587984 OP.201995/E3 Size 1 IP20.dxf.dxf

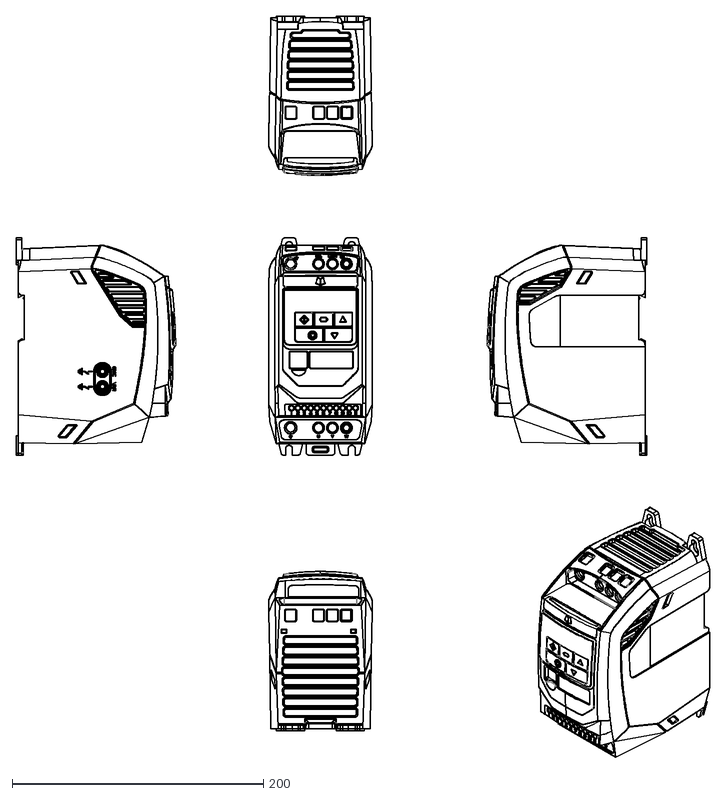
[picture p26: CAD file, 2021-07-15]
2019/Cabina Extractora 180 SGS #004587984 OP.201995/E3 Size 1 IP20.dxf.dxf
552.2 x 590.1
