judapies/Cabina-Extractora/2020/Cabina Extractora Con Ductos 180 GLCD Vidrio Electrico Artilab #004588305 OP202041/Schematic/CFLGLCD_V16.DXF

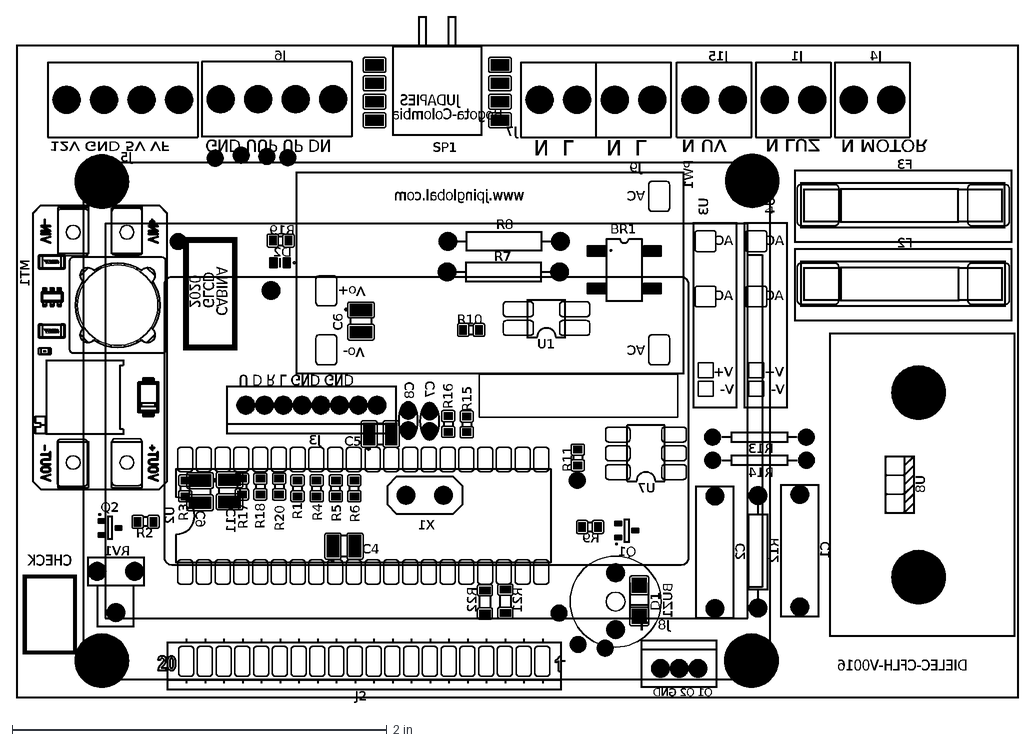
[picture p27: CAD file, 2021-07-15]
2020/Cabina Extractora Con Ductos 180 GLCD Vidrio Electrico Artilab #004588305 OP202041/Schematic/CFLGLCD_V16.DXF
J2
CABINA
GLCD
2020
JUDAPIES
www.jpinglobal.com
Bogota-Colombia
U2
AC
Vo+
Vo-
PW1
MT1
X1
C7
C8
R9
Q1
+
BUZ1
D1
J3
R1
R4
R5
R6
J7
J9
RV1
C4
C5
R3
N L
C9
C11
C6
BR1
R7
R8
U1
R16
V+
V-
U3
J15
R15
U4
R11
U7
R13
R14
C2
U8
R12
C1
F2
J1
J4
J5
R10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
