judapies/Cabina-Extractora/(list of files, cad)

Other CAD files:
2014/Cabina Extractora 180/Plano Electrico/Plano_Electrico_Cabina_Flujo_Vertical/Distribución de Conexiones.dwg
2015/Cabina Extractora con Sensor Aire y Filtro-Damper/Universidad de la Amazonia/Plano Electrico Cabina Extractora 110V/ConexionesCajaElectrica.dwg
2016/Cabina Sin Ductos Avantika #004587580/Plano Electrico CEH Sin Ductos/Conexiones_Panel_Control.dwg
2016/Cabinas_Alfa&Omega/Cabina # 004587550/Plano Electrico CEH 110V/DiagramaConexiones/Conexiones.dwg
2016/Cabinas_Alfa&Omega/Cabina # 004587550/Schematic Final/Cabina_Extractora_Sensor_Caja.dwg
2016/Cabinas_Alfa&Omega/Cabina # 004587577/Plano Electrico CEH 110V/DiagramaConexiones/Conexiones.dwg
2016/Proyecto CAR/Cabina Extractora con Sensor Aire y Filtro-Damper/Cabinas CAR/Plane Electrico CEH 220V/DiagramaConexiones/Conexiones.dwg
2016/Proyecto CAR/Cabina Extractora con Sensor Aire y Filtro-Damper/Cabinas CAR/Plano Electrico Cabina Extractora 110V/CajaElectrica.dwg
2016/Proyecto CAR/Cabina Extractora con Sensor Aire y Filtro-Damper/Cabinas CAR/Schematic Final/Cabina_Extractora_Sensor_Caja.dwg
2016/Proyecto CAR/Cabinas CAR/Plane Electrico CEH 220V/DiagramaConexiones/Conexiones.dwg
2016/Proyecto CAR/Cabinas CAR/Plano Electrico Cabina Extractora 110V/CajaElectrica.dwg
2017/110/Cabina Extractora 110 Avantika #004587602/Plano Electrico CEH 110V/DiagramaConexiones/Conexiones.dwg
2017/110/Cabina Extractora 110 Instruelectronic #004587680/Plano Electrico CEH 110V/DiagramaConexiones/Conexiones.dwg
2017/110/Cabina Extractora 110 Instruelectronic #004587680/Schematic Final/Cabina_Extractora_Sensor_Caja.dwg
2017/110/Cabina Extractora 110 UPTC #004587682/Plano Electrico CEH 110V/DiagramaConexiones/Conexiones.dwg
2017/120/Cabina Extractora 120 Alfa&Omega #004587694/Plano Electrico CEH 110V/DiagramaConexiones/ConexionesElectricasYElectronicas.dwg
2017/120/Cabina Extractora 120 Bioelectronica #004587606/Plane Electrico CEH 110V/DiagramaConexiones/Conexiones.dwg
2017/120/Cabina Extractora 120 Biopolab #004587672/Plano Electrico CEH 110V/DiagramaConexiones/ConexionesElectricasYElectronicas.dwg
2017/120/Cabina Extractora 120 Biopolab #004587672/Schematic Final/Cabina_Extractora_Sensor_Caja.dwg
2017/120/Cabina Extractora 120 Control Remoto Avantika #004587683/Plano Electrico CEH 110V/DiagramaConexiones/Conexiones.dwg
2017/120/Cabina Extractora 120 Ecuador #004587617/Plano Electrico CEH 110V/DiagramaConexiones/Conexiones.dwg
2017/120/Cabina Extractora 120 Ecuador #004587617/Schematic Final/Cabina_Extractora_Sensor_Caja.dwg
2017/120/Cabina Extractora 120 Ecuador #004587618/Plano Electrico CEH 110V/DiagramaConexiones/Conexiones.dwg
2017/120/Cabina Extractora 120 Ecuador #004587619/Plano Electrico CEH 110V/DiagramaConexiones/ConexionesElectricasYElectronicas.dwg
2017/120/Cabina Extractora 120 Ecuador #004587619/Schematic Final/Cabina_Extractora_Sensor_Caja.dwg
2017/120/Cabina Extractora 120 Ecuador #004587620/Plano Electrico CEH 110V/DiagramaConexiones/ConexionesElectricasYElectronicas.dwg
2017/120/Cabina Extractora 120 Ecuador #004587621/Plano Electrico CEH 110V/DiagramaConexiones/Conexiones.dwg
2017/120/Cabina Extractora 120 Instituto Nacional de Metrologia #004587643/Plano Electrico CEH 110V/DiagramaConexiones/Conexiones.dwg
2017/120/Cabina Extractora 120 Instituto Nacional de Metrologia #004587643/Schematic Final/Cabina_Extractora_Sensor_Caja.dwg
2017/120/Cabina Extractora 120 UNAL #004587712/Plano Electrico CEH 110V/DiagramaConexiones/Conexiones.dwg
2017/120/Cabina Extractora 120 UNAL #004587712/Schematic Final/Cabina_Extractora_Sensor_Caja.dwg
2017/150/Cabina Extractora 150 UNAL #004587589/Plano Electrico CEH 110V/DiagramaConexiones/ConexionesElectricasYElectronicas.dwg
2017/160/Cabina Extractora 160 Instituto Nacional de Metrologia #004587617/Plano Electrico CEH 110V/DiagramaConexiones/ConexionesElectricasYElectronicas.dwg
2017/180/Cabina Extractora 180 Avantika #004587665/Plano Electrico CEH 110V/DiagramaConexiones/ConexionesElectricasYElectronicas.dwg
2017/90/Cabina Extractora 90 Indumil #004587588/Plano Electrico CEH 110V/DiagramaConexiones/Conexiones.dwg
2017/90/Cabina Extractora 90 Indumil #004587588/Schematic Final/Cabina_Extractora_Sensor_Caja.dwg
2018/Cabina Extractora 110 Avantika #004587792/Plano Electrico CEH 110V/DiagramaConexiones/Conexiones.dwg
2018/Cabina Extractora 110 Sin Ductos U. Antioquia #004587817/Plano Electrico CEGH SD/Conexiones_Panel_Control.dwg
2018/Cabina Extractora 120 ALFA&OMEGA#004587767/Plano Electrico CEH 110V/DiagramaConexiones/ConexionesElectricasYElectronicas.dwg
2018/Cabina Extractora 120 Avantika #004587741/Plano Electrico CEH 110V/DiagramaConexiones/Conexiones.dwg
2018/Cabina Extractora 120 Bajita Blamis #004587824/Plano Electrico CEH 110V/DiagramaConexiones/ConexionesElectricasYElectronicas.dwg
2018/Cabina Extractora 120 Bajita Blamis #004587824/Schematic Final/Cabina_Extractora_Sensor_Caja.dwg
2018/Cabina Extractora 120 Bajita Blamis #004587825/Plano Electrico CEH 110V/DiagramaConexiones/Conexiones.dwg
2018/Cabina Extractora 120 Bajita UPTC #0045877XX/Plano Electrico CEH 110V/DiagramaConexiones/ConexionesElectricasYElectronicas.dwg
2018/Cabina Extractora 120 Damper y Flujo Artilab #004587869/Plano Electrico CEH 110V/DiagramaConexiones/ConexionesElectricasYElectronicas.dwg
2018/Cabina Extractora 120 Damper y Flujo Artilab #004587870/Plano Electrico CEH 110V/DiagramaConexiones/Conexiones.dwg
2018/Cabina Extractora 120 Damper y Flujo Artilab #004587913/Plano Electrico CEH 110V/DiagramaConexiones/ConexionesElectricasYElectronicas.dwg
2018/Cabina Extractora 120 Intertek #004587713/Plano Electrico CEH 110V/DiagramaConexiones/ConexionesElectricasYElectronicas.dwg
2018/Cabina Extractora 120 Intertek #004587713/Schematic Final/Cabina_Extractora_Sensor_Caja.dwg
2018/Cabina Extractora 120 Seleccion Scrubber #004587790/Plano Electrico CEH 110V/DiagramaConexiones/ConexionesElectricasYElectronicas.dwg
2018/Cabina Extractora 120 Seleccion Scrubber #004587791/Plano Electrico CEH 110V/DiagramaConexiones/Conexiones.dwg
2018/Cabina Extractora 120 Sin Ductos Avantika #004587719/Plano Electrico CEH 110V/DiagramaConexiones/Conexiones.dwg
2018/Cabina Extractora 120 Sin Ductos Avantika #004587719/Schematic Final/Cabina_Extractora_Sensor_Caja.dwg
2018/Cabina Extractora 120 Sin Ductos Avantika #004587720/Plano Electrico CEH 110V/DiagramaConexiones/Conexiones.dwg
2018/Cabina Extractora 120 Sin Ductos Medida Presion #004587768/Plano Electrico/Plano Electrico Cabina CFLH/ConexionesElectricasYElectronicas.dwg
2018/Cabina Extractora 120 Sin Ductos Medidor Flujo #004587780/Plano Electrico CBA2/Conexiones_Panel_Control.dwg
2018/Cabina Extractora 120 Ventilador Interno FV GEINSP #004587844/Plano Electrico CEH 110V/DiagramaConexiones/ConexionesElectricasYElectronicas.dwg
2018/Cabina Extractora 150 Ventilador Externo Artilab #004587867/Plano Electrico CEH 110V/DiagramaConexiones/Conexiones.dwg
2018/Cabina Extractora 150 Ventilador Externo Artilab #004587868/Plano Electrico CEH 110V Sencilla/DiagramaConexiones/Conexiones.dwg
2018/Cabina Extractora 150 Ventilador Externo Avantika #004587828/Plano Electrico CEH 110V/DiagramaConexiones/Conexiones.dwg
2018/Cabina Extractora 90 Ventilador Interno #004587827/Plano Electrico CEH 110V/DiagramaConexiones/Conexiones.dwg
2018/Cabina Extractora Biobase #004587860/Plano Electrico CEGH GLCD/Conexiones Caja Electrica.dwg
2018/Cabina ExtractoraBajita 120 GrupoSala #004587878/Plano Electrico CEH 110V/DiagramaConexiones/ConexionesElectricasYElectronicas.dwg
2019/Cabina Extractora 120 Artilab #004587962 OP.201986/Plano Electrico CEH 110V/DiagramaConexiones/Conexiones.dwg
2019/Cabina Extractora 120 Avantika #004587912 OP.2019103/Plano Electrico CEH 110V/DiagramaConexiones/ConexionesElectricasYElectronicas.dwg
2019/Cabina Extractora 120 Avantika RF PLUS #004588080 OP2019146/Plano Electrico CEH 220V/DiagramaConexiones/ConexionesElectricasYElectronicas.dwg
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
