judapies/Cabina-Extractora/MANUAL DE EMSABLE CABINA EXTRACTORA SENCILLA.docx

EL SIGUIENTE DOCUMENTO ES PARA LA REALIZACION DE LA CABINA EXTRACTORA SENCILLA TODOS LOS DERECHOS RESERVADOS @CESARCABD FOLLOW ME EN INSTRAGRAM

MANUAL DE ENSAMBLE PARTE ELECTRICA Y ELECTRONICA CABINA EXTRACTORA

CONTENIDO:

1 MATERIALES

  1.1 MATERIALES ELECTRONICOS
  1.2 MATERIALES ELECTRICOS
1 PRUEBAS
  1.1 PRUEBAS SIN MICROCONTROLADOR
  1.2 PRUENAS CON MICROCONTROLADOR
2 MONTAJE
3 CABLEADO

MATERIALES

  1.1 COMPONENTES ELECTRONICOS PARA SOLDAR TARJETA EXTRACTORA

COMPONENTE | CANTIDAD | EXISTENCIA
MOC 3041 | 2
TRIAC | 2
LM7805 | 1
PUENTE RECTIFICADOR | 1
BORNERA 2 PINES | 4
CONDENSADOR 470Uf | 1
CONDENSADOR 10Uf | 1
DIODO 1N4004 | 1
CONDENSADOR 104 | 2
CONDENSADOR 22Pf | 2
REOSTATO 10K | 1
TIP41C | 1
GP 2 PINES | 1
GP 16 PINES | 2
GP 8 PINES | 1
CRISTAL DE CUARZO 4MHZ | 1
RESISTENCIA 10K | 6
RESISTENCIA 1K | 4
RESISTENICA 330 Ohm | 2
BOTONES TIPO HUEVO BLANCO | 4
POSTES PLASTICOS | 4
DISIPADOR MEDIANO | 1
REGLETA PROFESIONAL | 1
CONECTOR METALICO 2 PINES | 1
CONECTOR METALICO 8 PINES | 1
PANTALLA LCD 4X20 | 1
FUENTE 12 V 1.3 A | 1
BOTON RESET | 1

NOTA1: ANTES DE SOLDAR REVISAR POSIBLES UNIONES ENTRE LAS PISTAS EVITANDO ASI LA GENERACION DE CORTOS O EL MAL FUNCIONAMIENTO DE LA TARJETA.

  1.2 COMPONENTES ELECTRICOS

COMPONENTES | CANTIDAD | EXISTENCIA | OBSERVACIONES
BREAKER 1 POLO 4A | 1
BREAKER 1 POLO 10A | 1
TOMA ELECTRICA | 1
CONTACTOR 9ª | 1
FRENOS RIEL OMEGA | 4
PASACABLES PG11 | 4
CLAVIJA AMARILLA | 1
RIEL OMEGA | 2 | | 6CM C/U

CABLES | CANTIDAD(MTS) | TOLERANCIA(CM)
CABLE PODER | 3.10 | + 10
TOMA | 1.70 | +5
BOTONES | 1.15 | +10
LUZ | 40 | +10
MOTOR | 1 | +10

NOTA 2: DESPUES DE SOLDAR TODOS LOS COMPONENTES Y ANTES DE PASAR A REALIZAR LAS PRUEBAS SE DEBE LIMPIAR LA TARJETA CON LA AYUDA DE UN CEPLLIO Y VARSOL, LUEGO DE ESTO SECAR LA TARJETA Y QUITAR CUALQUIER RESIDUO QUE PUEDA QUEDAR EVITANDO ASI QUE SE PUEDA AFECTAR EL PROCESO.

1 PRUEBAS

UNA VEZ SE SOLDEN TODOS LOS COMPONENTES SE PASARÁ A REALIZAR LAS SIGUIENTES PRUEBAS DE FUNCIONAMIENTO

  1.1 PRUEBAS SIN MICROCONTROLADOR
- CONECTE LA TARJETA EXTRACTORA AL BANCO DE PRUEBAS 12 VOLTIOS DC A LA BORNERA VIN Y 110 VOLTIOS AC A LA BORNERA QUE INDICA L|N Y REALICE LAS SIGUIENTES MEDICIONES CON EL MULTIMETRO.

PRUEBA | RESULTADO(V) | OBSERVACION
VOLTAJE DC PIN 1 DEL CI | 5 VOLTIOS
VOLTAJE AC EN BORNERA LUZ | 115 VOLTIOS
VOLTAJE AC EN BORNERA MOTOR | 114.9 VOTIOS

  1.2 PRUEBAS CON EL MICROCONTROLADOR
- CON EL CI YA PROGRAMADO SE DEBEN REALIZAR LAS SIGUIENTES PRUEBAS DE FUNCIONAMIENTO.

PRUEBA | RESULTADO | OBSERVACION
AJUSTAR EL REOSTATO PARA EL CONTRASTE | OK
VERIFICAR PANTALLA | OK
VERIFICAR BOTONES | OK

2 CON LAS SIGUIENTE IMÁGEN SE REALIZARA EL MONTAJE DE LOS COMPONENTES ELECTRICOS COMO EL BREAKER, CONTACOR, FUENTE, RIEL OMEGA, Y LA TARJETA ELECTRONICA. TAMBIEN SE ESPECIFICA LAS MEDIDAS DE LOS PASACABLES Y CONECTRORES METALICOS QUE HAY QUE REALIZAR UNA VEZ SE TENGA TODO MONTADO COMO SE OBSERVA EN LA IMAGEN 1 YA SE PUEDE EMPEZAR A CABLEAR.

NOTA 3. RECORDAR QUE EL CABLEADO SE DEBE REALIZAR CON BLANCO (NEUTRO) Y NEGRO (LINEA). EN EL CASO DE LA FUENTE LA SALIDA DE VOLTAJE DC ES CON ROJO (POSITIVO) Y NEGRO (NEGATIVO) Y CON SU RESPECTIVO NUMERO INDICADO EN EL PLANO DE CONEXIONES ADJUNTO A ESTE MANUAL DE ENSAMBLE

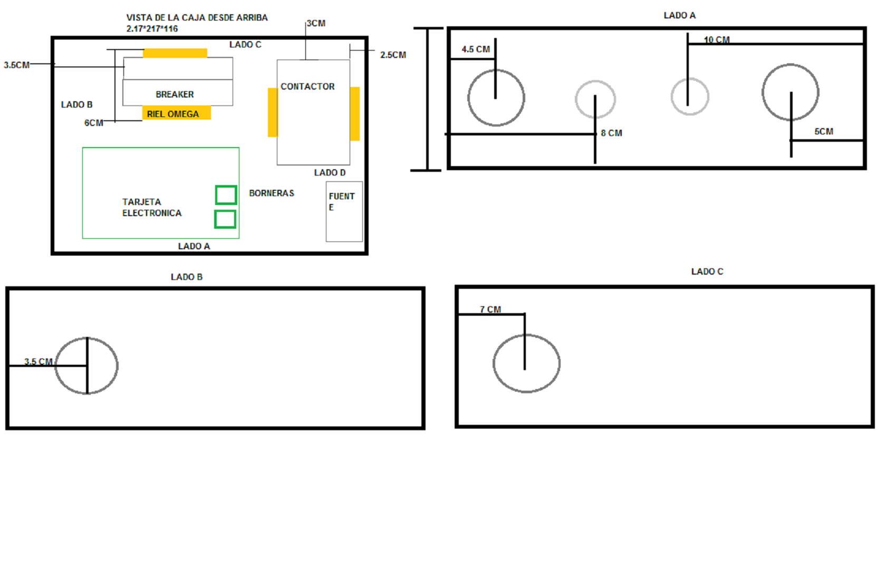
[picture p28: figure]

3 ARMADO

PARA EL ARMADO TENER EN CUENTA QUE EL CABLE DE BOTONES DEBE ESTAR DE LA SIGUIENTE MANERA:

CONECTOR METALICO | COLOR | FUNCION
PIN 1 | ROJO | UP
PIN 2 | NARANJA | DOWN
PIN 3 | VERDE | LEFT
PIN 4 | AZUL | RIGHT
PIN 5 | BLANCO | +
PIN 6 | CAFÉ | +
PIN 7 | AMARILLO | RESET
PIN 8 | NEGRO | RESET

- SE DEBE PUENTEAR CON DOS TRAMOS DE CABLES MÁS A EL + CONSIGUIENDO ASI OTRAS DOS FUENTES DE CONEXIÓN PARA VCC.
- CONECTAR EL CABLE A LA CLAVIJA AMARILLA.
- COLOCAR LA PANTALLA CON TORNILLOS 1/8” X 3/4" CON GUASA Y LA TUERCA Y CONECTAR EL CABLE DE LA PANTALLA
- ENCENDER LA CABINA Y VERIFICAR LOS PARAMETROS.

CABINA EXTRACTORA DE GASES Y HUMO JP INGLOBAL
