judapies/Cabina-Extractora/2021/Cabina Extractora Sin Ductos 90TOPA GLCD CEMMIT #004588499 OP202114/Schematic/Gerber_Mufla/Mufla - CADCAM Bottom Solder Resist.TXT

G04 PROTEUS RS274X GERBER FILE*
%FSLAX24Y24*%
%MOIN*%
%ADD71C,0.0800*%
%ADD70C,0.0900*%
%ADD28C,0.2900*%
%ADD18C,0.1500*%
%ADD29C,0.1300*%
%ADD72C,0.1800*%
%ADD73R,0.1000X0.1000*%
%ADD30C,0.1100*%
%ADD17C,0.1000*%
%ADD31R,0.0700X0.0700*%
%ADD12C,0.0700*%
%ADD32R,0.0850X0.1400*%
%ADD33R,0.1400X0.0850*%
%ADD34R,0.1000X0.0800*%
%ADD22C,0.0080*%
G54D71*
X+18015Y+25533D03*
X+29527Y+16259D03*
X+31354Y+16629D03*
X+19173Y+25472D03*
G54D70*
X+6220Y+23228D03*
X+6614Y+16811D03*
X+4118Y+25024D03*
X+13952Y+20543D03*
X+8931Y+22742D03*
X+31377Y+24724D03*
G54D28*
X+1456Y+1496D03*
G54D18*
X+4330Y+2440D03*
X+6330Y+2440D03*
G54D29*
X+9015Y+3385D03*
X+11015Y+1385D03*
X+9015Y+1385D03*
X+11015Y+3385D03*
G54D72*
X+24803Y+2913D03*
X+14960Y+2913D03*
G54D73*
X+18724Y+2125D03*
X+19724Y+2125D03*
X+20724Y+2125D03*
X+29055Y+12070D03*
X+29055Y+13070D03*
X+29055Y+14070D03*
G54D70*
X+7362Y+5118D03*
X+11362Y+5118D03*
G54D30*
X+21637Y+6102D03*
X+17637Y+6102D03*
G54D29*
X+10551Y+7913D03*
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
