judapies/Cabina-Extractora/2014/Manual_Cabina_Extractora_2014.docx

1. Encienda la Cabina de Flujo Laminar Vertical con el botón de encendido ON/OFF.
2. Al encender la cabina, aparecerá el siguiente mensaje en pantalla.

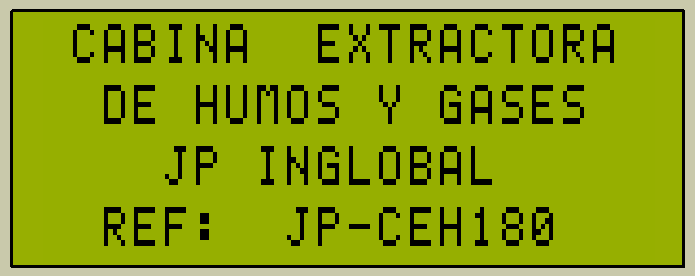
[picture p31: figure]

3. A continuación, debe ingresar la contraseña para poder acceder a operar la cabina. Recuerde que la contraseña por defecto es 0000.

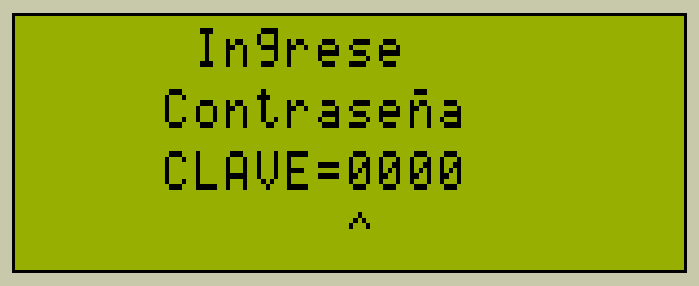
[picture p32: figure]

4. Si ingresa correctamente la contraseña aparecerán los siguientes mensajes.

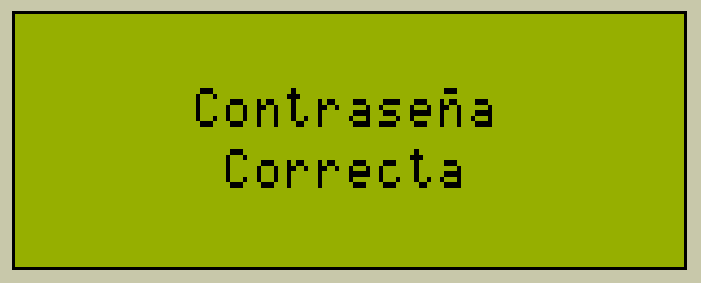
[picture p33: figure]
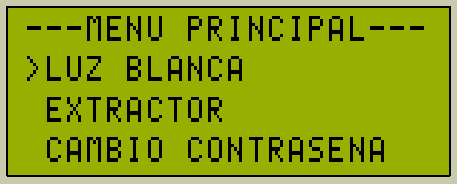
[picture p34: figure]

5. Una vez en el menú principal aparecerán las opciones de:
  a. Luz Blanca: Permite controlar el encendido y apagado de la luz blanca.

Para ingresar al submenú de “LUZ BLANCA”, ubique el cursor (>) en LUZ BLANCA utilizando las teclas ó y oprima la tecla para ingresar. A continuación aparecerá el siguiente mensaje.

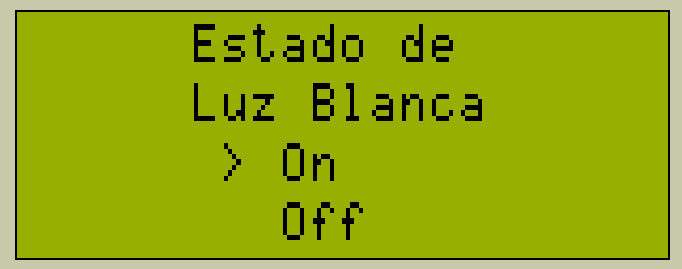
[picture p35: figure]

Para encender la “LUZ BLANCA”, ubique el cursor (>) en On utilizando las teclas ó y oprima la tecla para ingresar. A continuación aparecerá el siguiente mensaje.

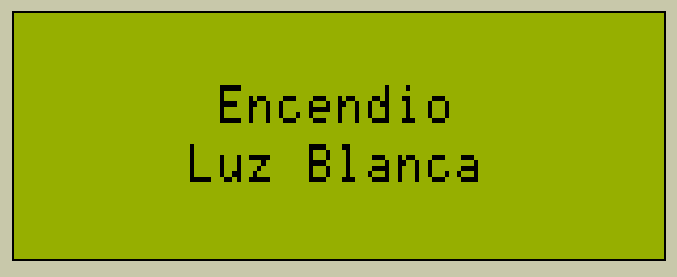
[picture p36: figure]

Para apagar la “LUZ BLANCA”, ubique el cursor (>) en Off utilizando las teclas ó y oprima la tecla para ingresar. A continuación aparecerá el siguiente mensaje.

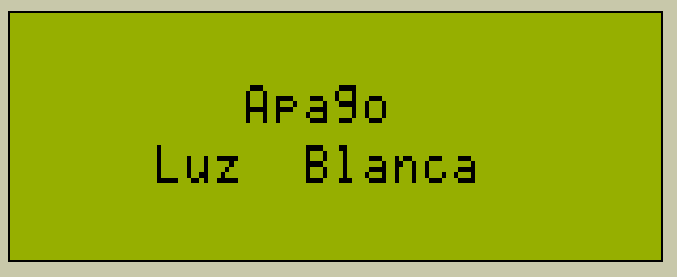
[picture p37: figure]

  b. Extractor: Permite controlar el encendido y apagado del ventilador.

Para ingresar al submenú de “EXTRACTOR”, ubique el cursor (>) en EXTRACTOR utilizando las teclas o y oprima la tecla para ingresar. A continuación aparecerá el siguiente mensaje.

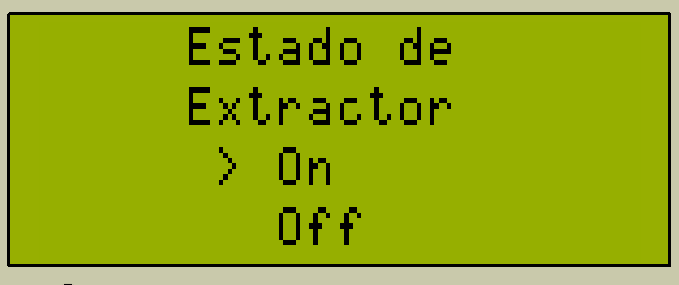
[picture p38: figure]

Para encender el “EXTRACTOR”, ubique el cursor (>) en On utilizando las teclas ó y oprima la tecla para ingresar. A continuación aparecerá el siguiente mensaje.

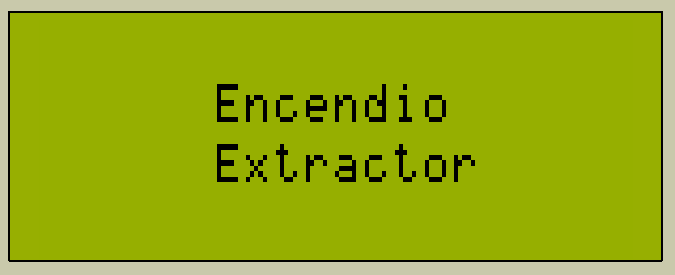
[picture p39: figure]

Para apagar el “EXTRACTOR”, ubique el cursor (>) en Off utilizando las teclas ó y oprima la tecla para ingresar. A continuación aparecerá el siguiente mensaje.

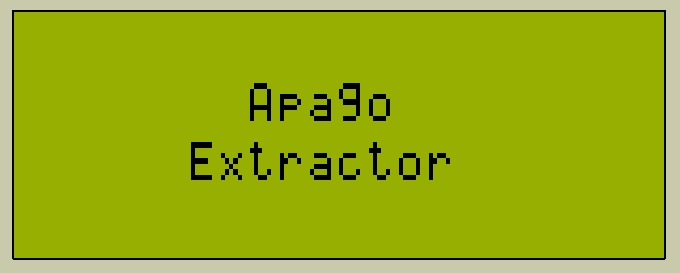
[picture p40: figure]

  c. Cambio de Contraseña: Permite modificar la contraseña de la cabina.

Para modificar la contraseña ingrese la contraseña con la que inicio la cabina, posteriormente ingrese la nueva contraseña.
