judapies/Cabina-Extractora/2018/Cabina Extractora 150 Ventilador Externo Artilab #004587868/Instructivo_CEGH150.docx

1. OBJETIVO.

Describir el manejo de la Cabina Extractora de Gases y Humos suministrada por JP Inglobal.

2. ALCANCE.

En este instructivo se describe el uso correcto del equipo y las precauciones que se deben tener con su manejo.

3. DEFINICIONES Y ABREVIATURAS.

Cabina Extractora de Gases y Humos: Equipo capaz de extraer gases que se generan en el área interna del equipo, esto se logra utilizando presión negativa generada por un extractor de aire.

Scrubber Húmedo: Equipo capaz de eliminar contaminantes contenidos en un flujo de gas.

4. RESPONSABILIDAD Y AUTORIDAD.

Las personas encargadas de realizar las reacciones químicas que de una u otra manera, generan humos o gases tóxicos, deben usar la cabina obligatoriamente y deben reportar a sus superiores, cualquier anomalía en la efectividad de la cabina.

5. CONDICIONES DE SEGURIDAD.

El laboratorista, debe mantener el vidrio de la cabina en posición de trabajo (20 cms de levante) mientras realice sus operaciones y aunque no se encuentre presente manipulando sustancias, debe dejar el vidrio en esta posición.

Para entrar o retirar equipos, el vidrio podrá ser levantado a mayores alturas, pero concluida la operación de extracción o introducción de equipos, matraces y cualquier objeto mayor a 20 cms, se debe volver el vidrio a esa altura.

6. EQUIPOS Y MATERIALES.
- Todos los elementos químicos que usara en sus reacciones
- Todos los envases
- Todos los equipos y mangueras necesarias.
7. INSTRUCCIONES DE TRABAJO / OPERACION.
1- La cabina debe estar energizada, es decir su clavija de alimentación, conectada al suministro eléctrico adecuado, según el modelo
2- La cabina, aunque se energice, inicia en una condición de reposo o “sleep” donde todos los elementos (luces, motores, pantallas) se encuentran apagados. Para iniciar su trabajo
3- Para iniciar las operaciones, se debe presionar en primer lugar el botón de ON/OFF, ubicado en el panel de botones. Si todo se encuentra bien, la pantalla LCD que posee la cabina, mostrará por unos segundos, una presentación con el modelo de la cabina y nombre de la empresa fabricante (JP INGLOBAL)
4- A continuación solicitara la clave de usuario de 4 dígitos y si esta es correcta, se indicara el proceso de purga, el cual durara el tiempo que tenga programada la cabina en sus parámetros (Se recomienda un minuto) Si el tiempo de purga fuera muy largo y se desea saltarse este tiempo, se puede presionar la tecla de flecha izquierda o Motor, para salir de la purga.
5- Una vez terminada la fase de purga, el equipo queda listo para funcionar y mediante 4 pulsadores se puede realizar las funciones básicas como: Prender y apagar la luz, Prender y apagar el motor, entrar al menú de configuración de parámetros y apagar completamente la cabina. Para una descripción detallada del menú de configuración y comandos, refiérase al Manual de Usuario, entregado junto con la cabina.

PRECAUCIONES

1- La cabina suministrada, al ser un equipo con scrubber húmedo, no requiere cambios de filtro u otros consumibles.
2- Evite golpear el vidrio corredizo y derramar líquidos sobre los controles
3- Si escucha algún ruido extraño en el sistema de extracción (Ventiladores) repórtelo al servicio técnico.
8. DESCRIPCION DE LOS CONTROLES Y CALIBRACIÓN.

El equipo no posee controles de verificación, y tampoco proceso de calibración, pues no es un equipo de medición, sino de operación.

9. DOCUMENTOS DE REFERENCIA Y BIBLIOGRAFIA.

Manual de Usuario de Cabina Extractora JP IOnglobal..

10. CONTROL DE CAMBIOS.

Versión No. | Fecha emisión AÑO MES DIA | | | Resumen del cambio

11. ANEXOS.

Elaboró: AÑO / MES / DIA ALVARO RODRÍGUEZ LÓPEZ Coordinador Laboratorio FQ Revisó: AÑO / MES / DIA ELENA PEREZ MEDINA Director Técnico Aprobó: AÑO / MES / DIA CESAR RAMIREZ AMAYA Gerente General La información contenida en el presente documento es propiedad de EMICAL S.A.S. Es SECRETA Y CONFIDENCI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

I 001 MANEJO DE CABINA EXTRACTORA DE GASES Y HUMOS JP INGLOBAL Versión No.1 Página: 3 de 3
