judapies/Cabina-Extractora/2018/Cabina Extractora 110 Avantika #004587792/Plano Electrico CEH 110V/ConexionesElectricasYElectronicas.pdf

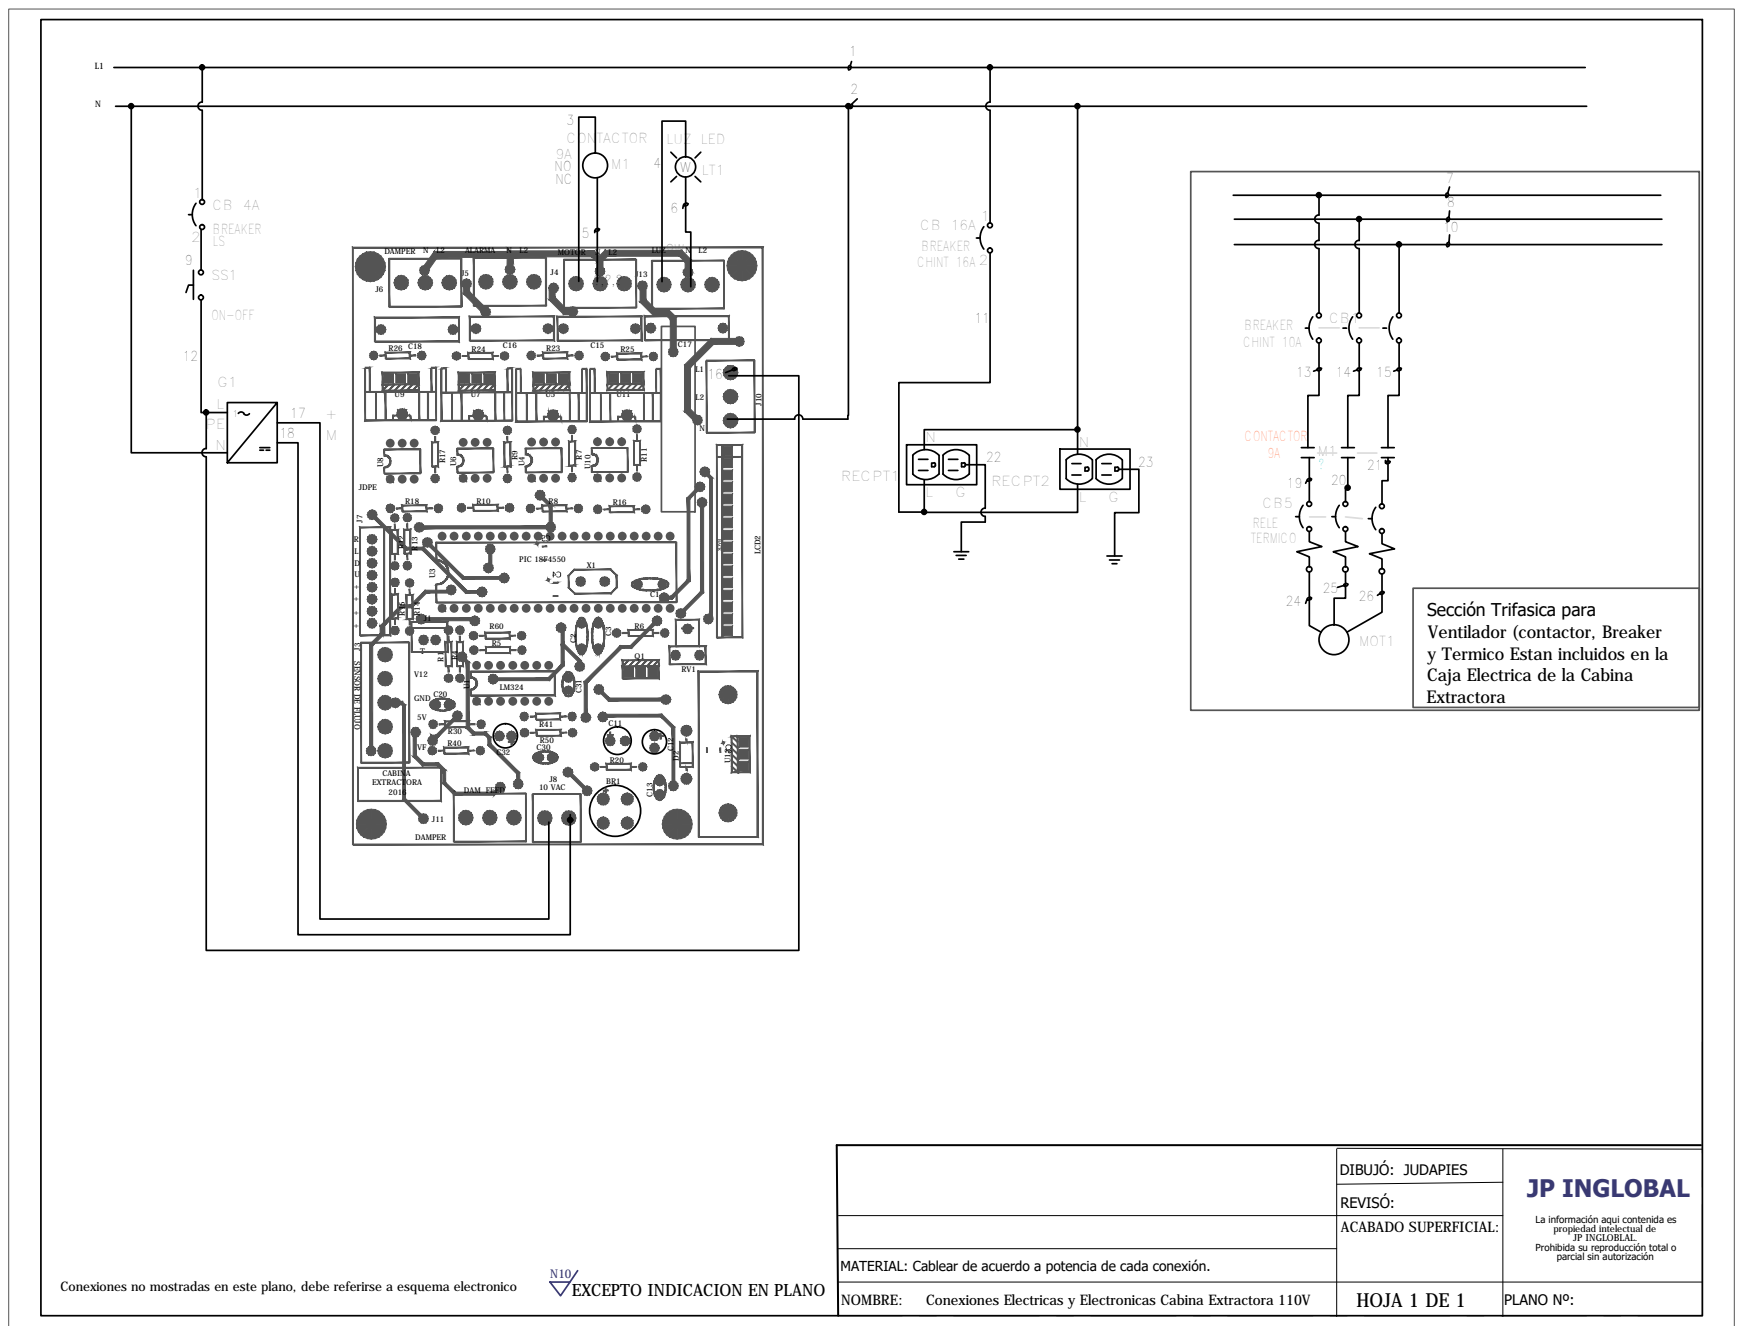
[picture p81: page 1]

LCD2 LT1 9WLUZ LED W ? 9A CONTACTOR M1 CONTACTOR ?,?,? NONC9A M1 6HFFLyQ7ULIDVLFDSDUD

C3 JDPE RLDU++++ LM324PIC 18F4550 DAMPER N L2 ALARMA N L2 MOTOR N L2 LUZ N L2 L1L2N 10 VAC - DAM FEED TV12 GND 5VVF

SENSOR DE FLUJO DAMPER CABINA EXTRACTORA 2016 J1

Ventilador (contactor, Breaker
y Termico Estan incluidos en la
