judapies/Cabina-Extractora/2018/Cabina Extractora 110 Sin Ductos U. Antioquia #004587817/Documentos/ENSAMBLE GENERAL CEH-110-DL 2018.PDF

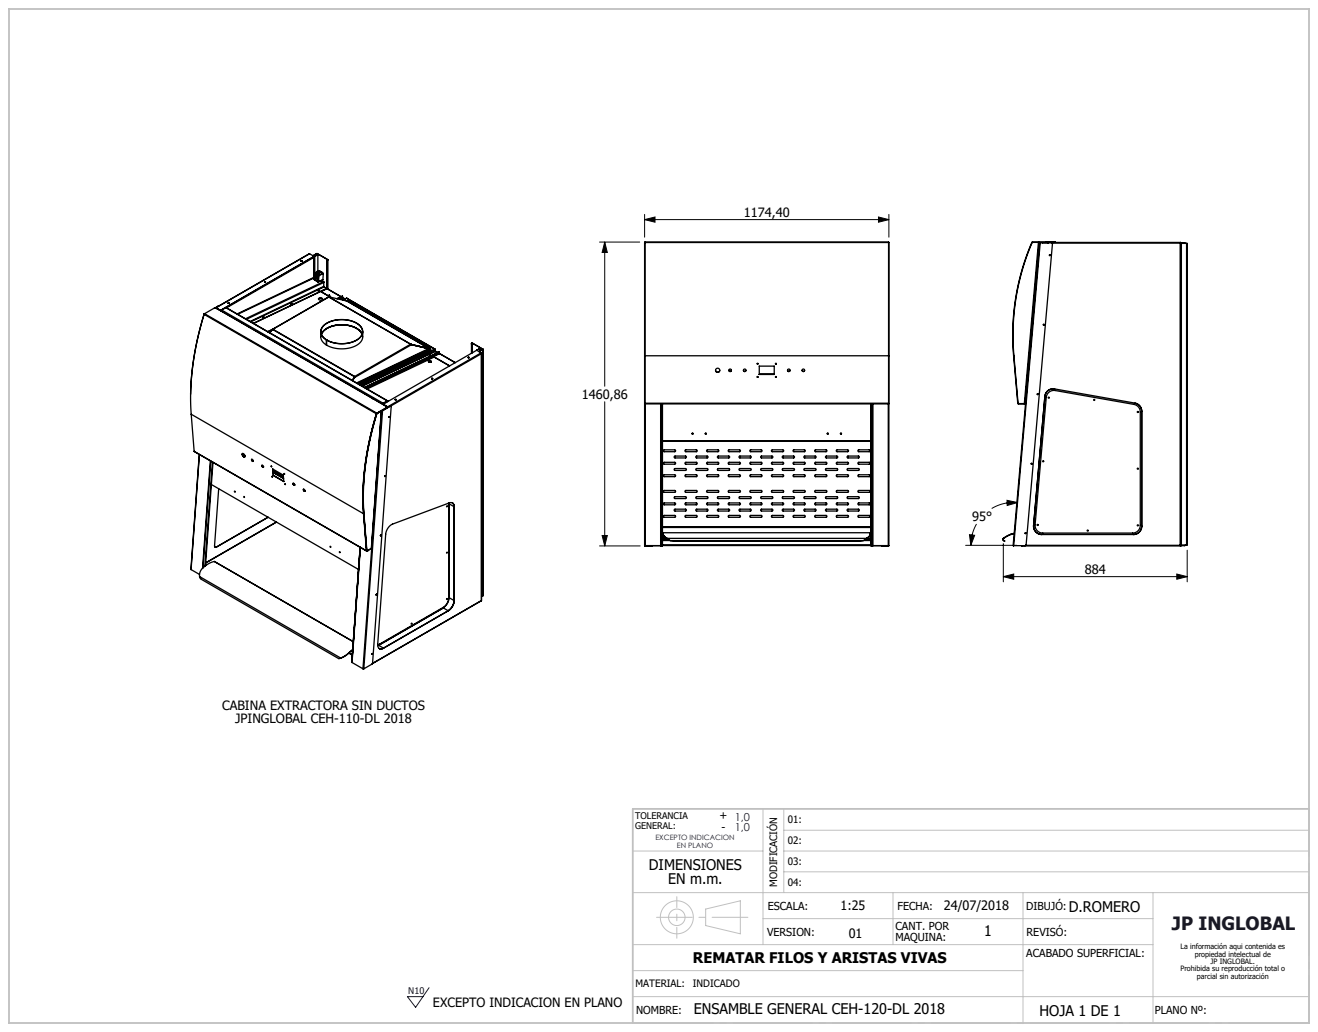
[picture p82: page 1]
JP INGLOBAL; EXCEPTO INDICACION EN PLANO; ACABADO SUPERFICIAL:; TOLERANCIA; + GENERAL:; HOJA 1 DE 1; PLANO Nº:; CANT. POR

CABINA EXTRACTORA SIN DUCTOS
JPINGLOBAL CEH-110-DL 2018

REMATAR FILOS Y ARISTAS VIVAS

La información aqui contenida es
propiedad intelectual de
JP INGLOBAL.
Prohibida su reproducción total o
parcial sin autorización

MATERIAL:
ENSAMBLE GENERAL CEH-120-DL 2018

EXCEPTO INDICACION EN PLANO
