judapies/Cabina-Extractora/2018/Cabina Extractora 110 Avantika #004587792/Documentos/ENSAMBLE GENERAL CEH-120-PP.PDF

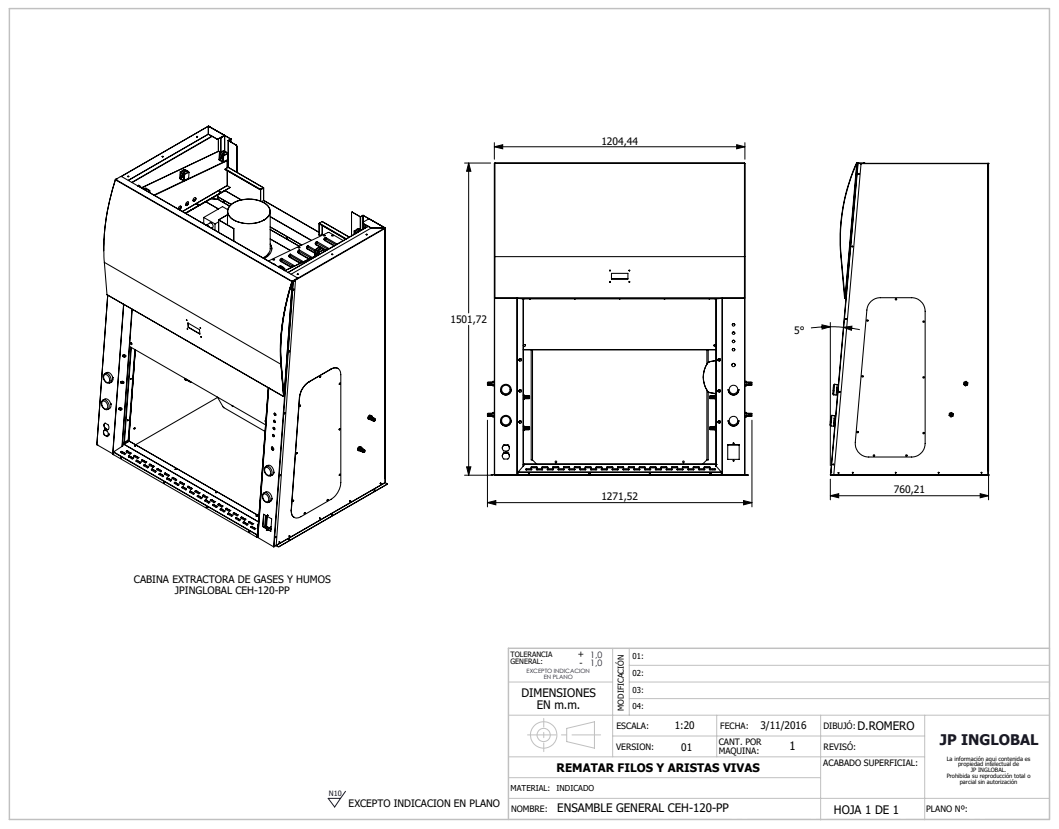
[picture p83: page 1]
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

CABINA EXTRACTORA DE GASES Y HUMOS
JPINGLOBAL CEH-120-PP

REMATAR FILOS Y ARISTAS VIVAS

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

MATERIAL:
ENSAMBLE GENERAL CEH-120-PP

EXCEPTO INDICACION EN PLANO
