judapies/Cabina-Extractora/2021/Cabina Extractora Sin Ductos 90TOPA GLCD CEMMIT #004588499 OP202114/Schematic/Mufla.PDF

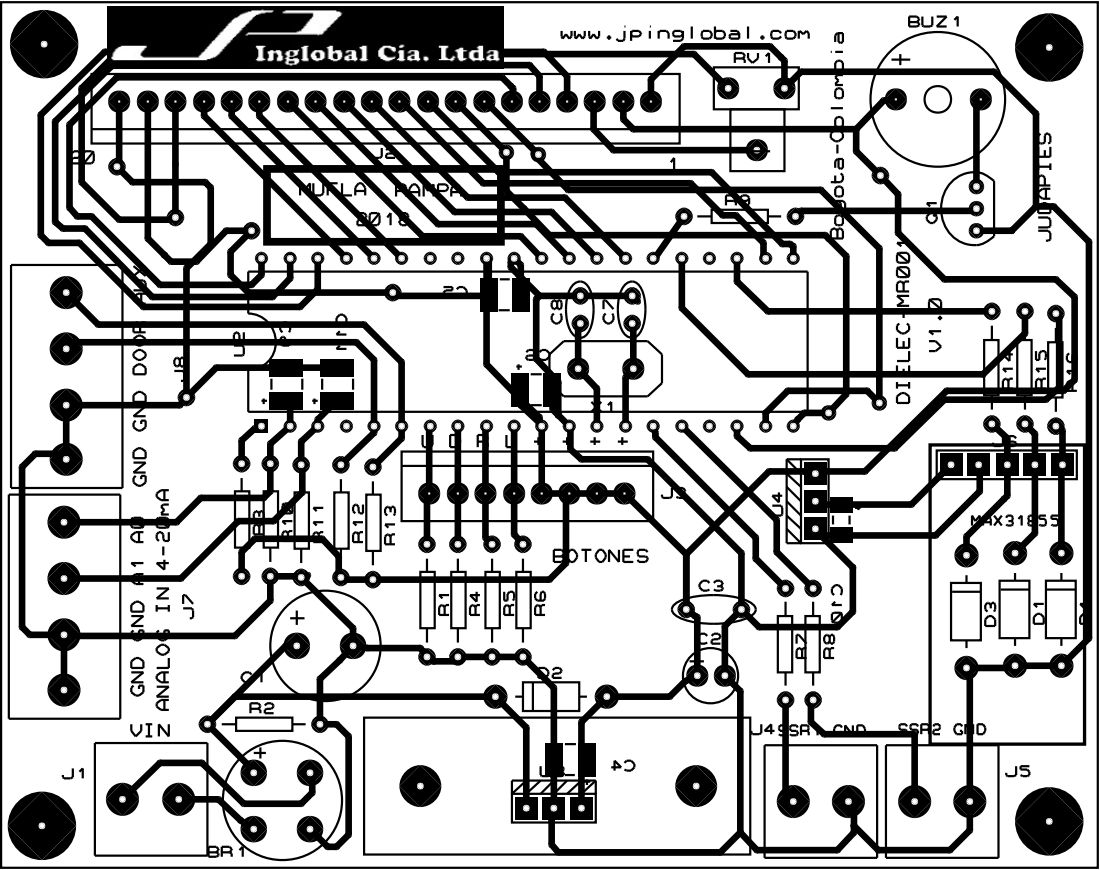
[picture p84: page 1]
