judapies/Cabina-Extractora/(list of files, drawings)

Other design files:
2014/Cabina Extractora 180/Schematic/Cabina_Flujo_Vertical.DSN
2014/Cabina Extractora 180/Schematic/Cabina_Flujo_Vertical.LYT
2015/Cabina Extractora con Sensor Aire y Filtro-Damper/Intertek/Schematic/Cabina_Extractora_Sensor2.LYT
2015/Cabina Extractora con Sensor Aire y Filtro-Damper/Intertek/Schematic/Cabina_Extractora_Sensor.DSN
2015/Cabina Extractora con Sensor Aire y Filtro-Damper/Intertek/Schematic/Cabina_Extractora_Sensor.LYT
2015/Cabina Extractora con Sensor Aire y Filtro-Damper/Intertek/Schematic/Control_Damper.DSN
2015/Cabina Extractora con Sensor Aire y Filtro-Damper/Intertek/Schematic/Control_Damper.LYT
2015/Cabina Extractora con Sensor Aire y Filtro-Damper/Universidad de la Amazonia/Schematic/Cabina_Extractora_Sensor2.LYT
2015/Cabina Extractora con Sensor Aire y Filtro-Damper/Universidad de la Amazonia/Schematic/Cabina_Extractora_Sensor.DSN
2015/Cabina Extractora con Sensor Aire y Filtro-Damper/Universidad de la Amazonia/Schematic/Cabina_Extractora_Sensor.LYT
2015/Cabina Extractora con Sensor Aire y Filtro-Damper/Universidad de la Amazonia/Schematic/Control_Damper.DSN
2015/Cabina Extractora con Sensor Aire y Filtro-Damper/Universidad de la Amazonia/Schematic/Control_Damper.LYT
2015/Cabina Extractora con Sensor Aire-Damper/Schematic/Cabina_Extractora_Sensor2.LYT
2015/Cabina Extractora con Sensor Aire-Damper/Schematic/Cabina_Extractora_Sensor.DSN
2015/Cabina Extractora con Sensor Aire-Damper/Schematic/Cabina_Extractora_Sensor.LYT
2015/Cabina Extractora con Sensor Aire-Damper/Schematic/Control_Damper.DSN
2015/Cabina Extractora con Sensor Aire-Damper/Schematic/Control_Damper.LYT
2015/Cabina Extractora con Sensor Aire-VariadorVelocidad/Paleosedes/Schematic/Cabina_Extractora_Sensor2.LYT
2015/Cabina Extractora con Sensor Aire-VariadorVelocidad/Paleosedes/Schematic/Cabina_Extractora_Sensor.DSN
2015/Cabina Extractora con Sensor Aire-VariadorVelocidad/Paleosedes/Schematic/Cabina_Extractora_Sensor.LYT
2015/Cabina Extractora con Sensor Aire-VariadorVelocidad/Paleosedes/Schematic/Control_Damper.DSN
2015/Cabina Extractora con Sensor Aire-VariadorVelocidad/Paleosedes/Schematic/Control_Damper.LYT
2015/Cabina Extractora con Sensor Aire-VariadorVelocidad/Paleosedes/Schematic/Etapa_Potencia_AC.DSN
2015/Cabina Extractora con Sensor Aire-VariadorVelocidad/Paleosedes/Schematic/Etapa_Potencia_AC.LYT
2015/Cabina Extractora Simple/Cabina Extractora 90/Schematic/Cabina_Flujo_Vertical.DSN
2015/Cabina Extractora Simple/Cabina Extractora 90/Schematic/Cabina_Flujo_Vertical.LYT
2015/Cabina Extractora Simple/Cabina Extractora 120 - Cenipalma Tumaco/Schematic/Cabina_Flujo_Vertical.DSN
2015/Cabina Extractora Simple/Cabina Extractora 120 - Cenipalma Tumaco/Schematic/Cabina_Flujo_Vertical.LYT
2015/Cabina Extractora Simple/Cabina Extractora 120 - MAT/Schematic/Cabina_Flujo_Vertical.DSN
2015/Cabina Extractora Simple/Cabina Extractora 120 - MAT/Schematic/Cabina_Flujo_Vertical.LYT
2015/Cabina Extractora Simple/Cabina Extractora 150 - Cenipalma Cumaral/Schematic/Cabina_Flujo_Vertical.DSN
2015/Cabina Extractora Simple/Cabina Extractora 150 - Cenipalma Cumaral/Schematic/Cabina_Flujo_Vertical.LYT
2016/Cabina Sin Ductos Avantika #004587580/Schematic/CabinaExtractoraSinDuctos.DSN
2016/Cabina Sin Ductos Avantika #004587580/Schematic/CabinaExtractoraSinDuctos.LYT
2016/Cabina Sin Ductos Avantika #004587580/Schematic/Schematic Puente H MosFet/Puente_H_MosFet.DSN
2016/Cabina Sin Ductos Avantika #004587580/Schematic/Schematic Puente H MosFet/Puente_H_MosFet.LYT
2016/Cabinas_Alfa&Omega/Cabina # 004587550/Schematic Final/AdaptadorDB15-VGA.LYT
2016/Cabinas_Alfa&Omega/Cabina # 004587550/Schematic Final/AdaptadorLCD-2.LYT
2016/Cabinas_Alfa&Omega/Cabina # 004587550/Schematic Final/AdaptadorLCD-3.LYT
2016/Cabinas_Alfa&Omega/Cabina # 004587550/Schematic Final/AdaptadorLCD-VGA.LYT
2016/Cabinas_Alfa&Omega/Cabina # 004587550/Schematic Final/AdaptadorLCD.DSN
2016/Cabinas_Alfa&Omega/Cabina # 004587550/Schematic Final/AdaptadorLCD.LYT
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
